eSpark-Consulting-Group/eduardosuarez-roomonitor/Hardware-Designing/_Deliverable/Renderings/3D TopView.jpg

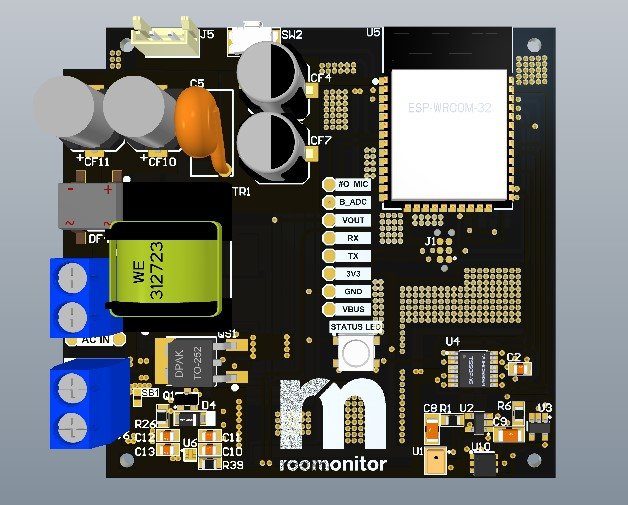
Hardware-Designing/_Deliverable/Renderings/3D TopView.jpg
