eSpark-Consulting-Group/eduardosuarez-roomonitor/Hardware-Designing/_Deliverable/Renderings/3D BottomView.jpg

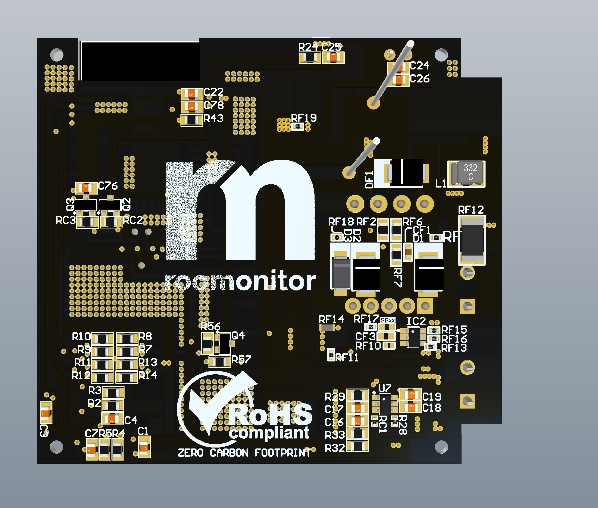
Hardware-Designing/_Deliverable/Renderings/3D BottomView.jpg
