eSpark-Consulting-Group/eduardosuarez-roomonitor/README.md

# RoomMonitor-Eduardo
Design and collaborate on the Hardware Design of IndoorMonitor and OutdoorMonitor for Eduardo Suarez.
