eSpark-Consulting-Group/eduardosuarez-roomonitor/Hardware-Designing/_Deliverable/Renderings/2D BottomView.jpg

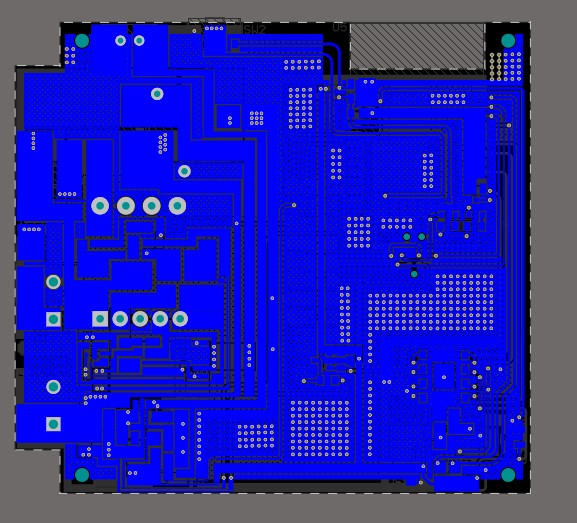
Hardware-Designing/_Deliverable/Renderings/2D BottomView.jpg
