eSpark-Consulting-Group/eduardosuarez-roomonitor/Hardware-Designing/_Deliverable/Renderings/2D C-View.jpg

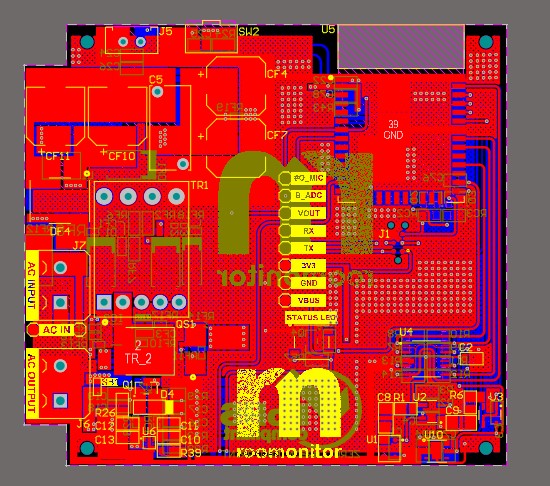
Hardware-Designing/_Deliverable/Renderings/2D C-View.jpg
