eSpark-Consulting-Group/eduardosuarez-roomonitor/Hardware-Designing/_Deliverable/Renderings/2D TopView.jpg

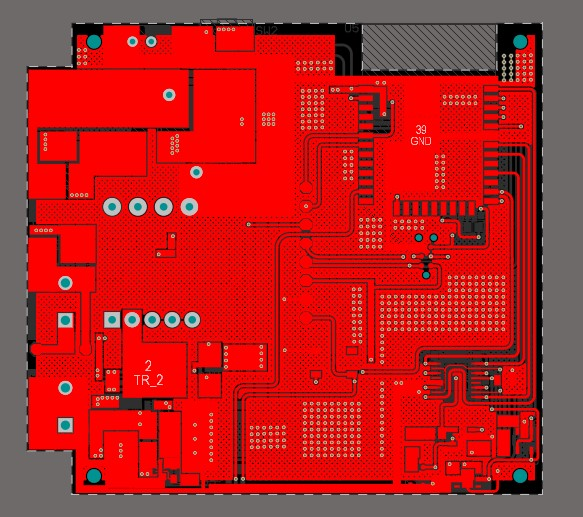
Hardware-Designing/_Deliverable/Renderings/2D TopView.jpg
