eSpark-Consulting-Group/eduardosuarez-roomonitor/Hardware-Designing/_Deliverable/Renderings/3D IsometricView.jpg

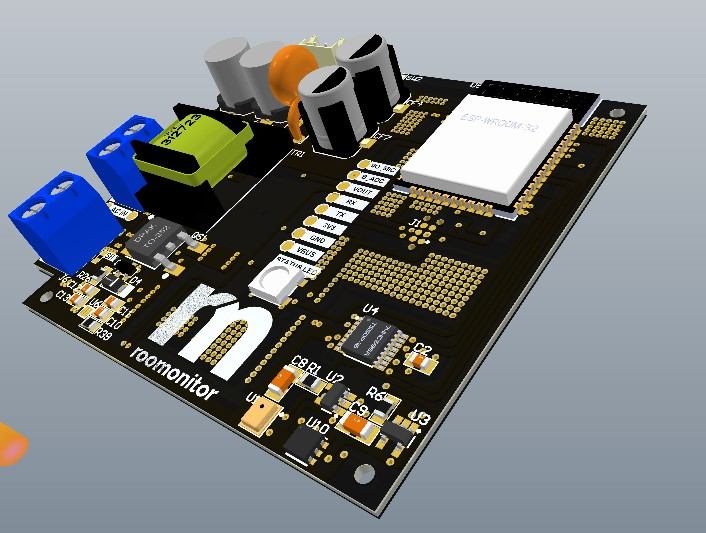
Hardware-Designing/_Deliverable/Renderings/3D IsometricView.jpg
