eSpark-Consulting-Group/eduardosuarez-roomonitor/Hardware-Designing/_Deliverable/Renderings/3D IsometricView_2.jpg

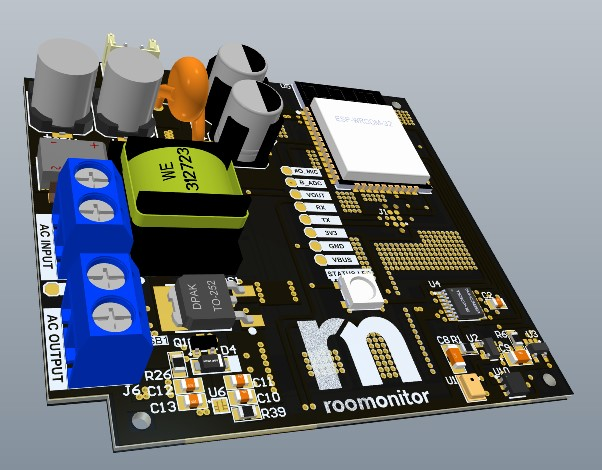
Hardware-Designing/_Deliverable/Renderings/3D IsometricView_2.jpg
