eSpark-Consulting-Group/eduardosuarez-roomonitor/Hardware-Designing/_Deliverable/BOM/EDU BOM.xlsx

Sheet: Sheet1
Bill of Material (BOM) for Eduardo_SMPS
S. No. | Comment Type | Description | Designator | Footprint (Package) | Manufacturer Part Number | Manufacturer | Value | Quantity | Total Quantity | Link | Unit Price(500) | Total Price (500) | Unit Price(1000) | Total Price (1000) | Unit Price(4000) | Total Price(4000) | Remarks
1 | Capacitor | CAP CER 0.1UF 50V Y5V 0805 | C1, C2, C3, C4, C7, C10, C12, C17, C19, C22, C24, C25, C76 | Cap0805 | CL21F104ZBCNNNC | Samsung | 0.1uF | 13 | 650 | Digikey (https://www.digikey.com/en/products/detail/samsung-electro-mechanics/CL21F104ZBCNNNC/3886665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) | $0.0122 | $7.93 | $0.00959 | $6.23 | $0.00802 | $5.21 | no alternate found
2 |  | CAP CER 1000PF 760VAC Y5U RADIAL | C5 | RAD-0.4 | 440LD10-R | Vishay | 1000pF | 1 | 50 | Mouser (https://eu.mouser.com/ProductDetail/Vishay-Cera-Mite/440LD10-R) |  | $0.00 | $0.37000 | $18.50 | $0.37000 | $18.50 | price start from 1000
3 |  | CAP CER 1UF 16V X7R 1206 | C8, C9 | Cap1206 | 1206YC105K4T2A | Kyocera AVX | 1uF | 2 | 100 | Digikey (https://www.digikey.com/en/products/detail/avx-corporation/1206YC105K4T2A/3081814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) |  | $0.00 |  | $0.00 |  | $0.00 | Alternate part on next sheet
4 |  | CAP CER 1UF 16V X7R 0805 | C11, C13, C16, C18, C78 | Cap0805 | CL21B105KOFNNNG | Samsung | 1uF | 5 | 250 | Digikey (https://www.digikey.com/en/products/detail/samsung-electro-mechanics/CL21B105KOFNNNG/3894469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) | $0.0175 | $4.37 | $0.01373 | $3.43 | $0.01249 | $3.12 | not needed to change price for 3000
5 |  | CAP CER 4.7UF 16V 10% X5R 0805 | C26 | Cap0805 | C0805C475K4PACTU | KEMET | 4.7UF | 1 | 50 | Digikey (https://www.digikey.com/en/products/detail/kemet/C0805C475K4PACTU/2057920) | $0.0632 | $3.16 | $0.05591 | $2.80 | $0.04862 | $2.43 | not need to change,price for 5000
6 |  | CAP CER 1000PF 200V X7R 0603 | CF1 | Cap0603 | 0603B102K201CT | Walsin Technologies | 1nF | 1 | 50 | Digikey (https://www.digikey.com/en/products/detail/walsin-technology-corporation/0603B102K201CT/9354876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) | $0.0218 | $1.09 | $0.01712 | $0.86 | $0.01432 | $0.72 | not need to change,price for 4000
7 |  | CAP CER 0.33UF 50V X7R 0603 | CF3 | Cap0603 | CGA3E3X7R1H334M080AB | TDK | 0.33uF | 1 | 50 | Digikey (https://www.digikey.com/en/products/detail/tdk-corporation/CGA3E3X7R1H334M080AB/4931466) |  | $0.00 |  | $0.00 |  | $0.00 | Alternate part on next sheet
8 |  | CAP ALUM 560UF 20% 10V SMD | CF4, CF7 | Custom | EEE-TC1A561UV | Panasonic | 560uF | 2 | 100 | Digikey (https://www.digikey.com/en/products/detail/panasonic-electronic-components/EEE-TC1A561UV/10290506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) | $0.5483 | $54.83 | $0.48375 | $48.38 | $0.43538 | $43.54 | not needed to change,price for 5000
9 |  | CAP ALUM 4.7UF 20% 400V SMD | CF10, CF11 | Custom | ULR2G4R7MNL1GS | Nichicon | 4.7uF | 2 | 100 | Digikey (https://www.digikey.com/en/products/detail/nichicon/ULR2G4R7MNL1GS/3664129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) | $0.3245 | $32.45 | $0.27323 | $27.32 | $0.23908 | $23.91 | not needed to change,price for 5000
10 | Diode | TVS DIODE 70.1V 113V DO214AA | D1 | SMB | SMBJP6KE82A-TP | MCC | -------- | 1 | 50 | Digikey (https://www.digikey.com/en/products/detail/micro-commercial-co/SMBJP6KE82A-TP/2345614) | $0.1235 | $6.17 | $0.10075 | $5.04 | $0.09750 | $4.88 | price for 3000,949 in stock
11 |  | DIODE GEN PURP 600V 1A SMB | D2 | SMB | MURS160-13 | Diodes | -------- | 1 | 50 | Digikey (https://www.digikey.com/en/products/detail/MURS160-13-F/MURS160-FDICT-ND/815906?curr=usd) |  | $0.00 |  | $0.00 |  | $0.00 | not in stock
12 |  | Diode Switching 100V 1A 2Pin SMA | D3 | SMA | RS1B-13-F | Diodes | -------- | 1 | 50 | Digikey (https://www.digikey.com/en/products/detail/diodes-incorporated/RS1B-13-F/717796) | $0.1050 | $5.25 | $0.07676 | $3.84 | $0.07070 | $3.54 | price for 5000
13 |  | DIODE SCHOTTKY 30V 1A SOD123W | D4 | SOD123W | PMEG3010ER,115 | NXP Semiconductors | -------- | 1 | 50 | Digikey (https://www.digikey.com/en/products/detail/nexperia-usa-inc/PMEG3010ER115/2119868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) | $0.1009 | $5.04 | $0.07372 | $3.69 | $0.07178 | $3.59 | price for 3000
14 |  | DIODE SCHOTTKY 40V 3A SMB | DF1 | SMB | B340LB-13-F | Diodes | -------- | 1 | 50 | Digikey (https://www.digikey.com/en/products/detail/diodes-incorporated/B340LB-13-F/755461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) | $0.1727 | $8.64 | $0.13635 | $6.82 | $0.13181 | $6.59 | price for 3000
15 |  | RECT BRIDGE GPP 1A 400V DFS | DF4 | Custom | DF04S-T | Diodes | -------- | 1 | 50 | Digikey (https://www.digikey.com/en/products/detail/diodes-incorporated/DF04S-T/1934941) | $0.1631 | $8.16 | $0.16312 | $8.16 | $0.12878 | $6.44 | price for 3000
16 | LED | ADDRESS LED DISC SERIAL RGB 1=10 | LED2 | 1655 | 1655 | Adafruit Industries | -------- | 1 | 50 | Digikey (https://www.digikey.com/en/products/detail/adafruit-industries-llc/1655/5154679) | $4.5000 | $225.00 | $4.50000 | $225.00 | $4.50000 | $225.00 | same unit for all
17 | Inductor | Ind Power Wirewound 470uH 10% 140mA 1812 | L1 | custom | 84474C | Murata | 470uH | 1 | 50 | Digikey (https://www.digikey.com/en/products/detail/murata-power-solutions-inc/84474C/5798743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) | $0.2295 | $11.47 | $0.22610 | $11.30 | $0.22610 | $11.30 | price for 2000
18 | Mosfet | MOSFET P-CHAN 24V SOT23 | Q1 | SOT-23 | DMP2045U-7 | Diodes | -------- | 1 | 50 | Digikey (https://www.digikey.com/en/products/detail/diodes-incorporated/DMP2045U-7/8275356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) | $0.1252 | $6.26 | $0.09292 | $4.65 | $0.08161 | $4.08 | price for 3000
19 |  | TRANS NPN 40V 0.6A SMD SOT23-3 | Q2, Q3 | SOT-23 | MMBT2222A-7-F | Diodes | -------- | 2 | 100 | Digikey (https://www.digikey.com/en/products/detail/diodes-incorporated/MMBT2222A-7-F/814503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) | $0.0393 | $3.93 | $0.02727 | $2.73 | $0.02382 | $2.38 | price for 3000
20 |  | MOSFET N-CH 50V 200MA SOT-23 | Q4 | SOT-23 | BSS138LT1G | ON Semiconductor | -------- | 1 | 50 | Digikey (https://www.digikey.com/en/products/detail/on-semiconductor/BSS138LT1G/918376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) | $0.0701 | $3.50 | $0.04871 | $2.44 | $0.04527 | $2.26 | price for 3000
21 |  | MOSFET N-CH 600V 2A DPAK | QS1 | DPAK | STD2HNK60Z | STMicroelectronics | -------- | 1 | 50 | Digikey (https://www.digikey.com/en/products/detail/stmicroelectronics/STD2HNK60Z/1653989) | $0.5304 | $26.52 | $0.43210 | $21.61 | $0.38740 | $19.37 | price for 5000
22 | Resistor | RES SMD 1K OHM 5% 1/2W 0805 | R1, R6 | RES0805 | ERJ-P06J102V | Panasonic | 1K | 2 | 100 | Digikey (https://www.digikey.com/en/products/detail/panasonic-electronic-components/ERJ-P06J102V/525197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) |  | $0.00 | $0.01584 | $1.58 | $0.01224 | $1.22 | not needed to change
23 |  | RES SMD 10K OHM 5% 1/2W 0805 | R2, R3, R4, R5, R8, R10, R12, R14, R24, R29, R39, R43, R56, R57, RC2, RC3 | RES0805 | ERJ-P06J103V | Panasonic | 10K | 16 | 800 | Digikey (https://www.digikey.com/en/products/detail/panasonic-electronic-components/ERJ-P06J103V/525198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) |  | $0.00 | $0.01584 | $12.67 | $0.01224 | $9.79 | not needed to change, price for 5000
24 |  | RES SMD 47K OHM 1% 1/3W 0805 | R7 | RES0805 | CRCW080547K0FKEAHP | Vishay | 47K | 1 | 50 | Digikey (https://www.digikey.com/en/products/detail/vishay-dale/CRCW080547K0FKEAHP/2222360) |  | $0.00 | $0.03150 | $1.57 | $0.03150 | $1.57 | same part with less price also less stock (https://www.digikey.com/en/products/detail/vishay-dale/CRCW080547K0JNEAHP/2222394)
25 |  | RES SMD 100K OHM 5% 1/2W 0805 | R9, R26 | RES0805 | ERJ-P06J104V | Panasonic | 100K | 2 | 100 | Digikey (https://www.digikey.com/en/products/detail/panasonic-electronic-components/ERJ-P06J104V/525199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) |  | $0.00 | $0.01584 | $1.58 | $0.01224 | $1.22 | not needed to change,, price for 5000
26 |  | RES SMD 220K OHM 5% 1/2W 0805 | R11 | RES0805 | ERJ-P06J224V | Panasonic | 220K | 1 | 50 | Digikey (https://www.digikey.com/en/products/detail/panasonic-electronic-components/ERJ-P06J224V/525240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) |  | $0.00 | $0.01584 | $0.79 | $0.01224 | $0.61 | not needed to change,, price for 5000
27 |  | RES SMD 470K OHM 1% 1/3W 0805 | R13 | RES0805 | CRCW0805470KFKEAHP | Vishay Dale | 470K | 1 | 50 | Digikey (https://www.digikey.com/en/products/detail/vishay-dale/CRCW0805470KFKEAHP/2227258) |  | $0.00 |  | $0.00 |  | $0.00 | Alternate part on next sheet
28 |  | RES SMD 665 OHM 1% 1/16W 0402 | R28 | Res0402 | RC0402FR-07665RL | Yageo | 665R | 1 | 50 | Digikey (https://www.digikey.com/en/products/detail/yageo/RC0402FR-07665RL/5281068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) |  | $0.00 | $0.00262 | $0.13 | $0.00188 | $0.09 | not needed to change,price for 5000
29 |  | RES SMD 1M OHM 5% 1/2W 0805 | R32, R33 | RES0805 | ERJ-P06J105V | Panasonic | 1M | 2 | 100 | Digikey (https://www.digikey.com/en/products/detail/panasonic-electronic-components/ERJ-P06J105V/525200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) |  | $0.00 | $0.01584 | $1.58 | $0.01224 | $1.22 | not needed to change,price for 5000
30 |  | RES SMD 10K OHM 1% 1/10W 0402 | RC1, RF11, RF17 | Res0402 | ERJ-2RKF1002X | Panasonic | 10K | 3 | 150 | Digikey (https://www.digikey.com/en/products/detail/panasonic-electronic-components/ERJ-2RKF1002X/192073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) |  | $0.00 | $0.00398 | $0.60 | $0.00285 | $0.43 | not needed to change,price for 5000
31 |  | RES 5.11M OHM 1% 1/4W 0805 | RF2, RF6, RF7 | RES 0805 | RK73H2ATTD5114F | KOA Speer | 5.11M | 3 | 150 | Digikey (https://www.digikey.com/en/products/detail/koa-speer-electronics-inc/RK73H2ATTD5114F/10234574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) |  | $0.00 | $0.00557 | $0.84 | $0.00399 | $0.60 | not needed to change,price for 5000
32 |  | RES 487 OHM 1% 1/10W 0402 | RF8 | Res0402 | RK73H1ETTP4870F | KOA Speer | 487R | 1 | 50 | Digikey (https://www.digikey.com/en/products/detail/koa-speer-electronics-inc/RK73H1ETTP4870F/9844141) |  | $0.00 |  | $0.00 |  | $0.00 | Alternate part on next sheet
33 |  | RES 10 OHM 5% 1/10W 0402 | RF10 | Res0402 | RK73B1ETTP100J | KOA Speer | 10R | 1 | 50 | Digikey (https://www.digikey.com/en/products/detail/koa-speer-electronics-inc/RK73B1ETTP100J/9843968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) |  | $0.00 | $0.00265 | $0.13 | $0.00190 | $0.10 | not needed to change,price for 5000
34 |  | RES SMD 10 OHM 5% 3W 2512 | RF12 | RES 2512 | 352210RJT | TE Connectivity CGS | 10R | 1 | 50 | Digikey (https://www.digikey.com/en/products/detail/te-connectivity-passive-product/352210RJT/5244975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) |  | $0.00 | $0.18411 | $9.21 | $0.18211 | $9.11 | not needed to change,price for 2000
35 |  | RES 4.64K OHM 1% 1/10W 0402 | RF13 | Res-0402 | RK73H1ETTP4641F | KOA Speer | 4.64K | 1 | 50 | Digikey (https://www.digikey.com/en/products/detail/koa-speer-electronics-inc/RK73H1ETTP4641F/9844303) |  | $0.00 | $0.00398 | $0.20 | $0.00285 | $0.14 | not needed to change,price for 5000
36 |  | RES SMD 2.05 OHM 1% 1/10W 0603 | RF14 | Res0603 | CRCW06032R05FKEA | Vishay Dale | 2.05R | 1 | 50 | Digikey (https://www.digikey.com/en/products/detail/vishay-dale/CRCW06032R05FKEA/1961570) |  | $0.00 | $0.00694 | $0.35 | $0.00498 | $0.25 | not needed to change,price for 5000
37 |  | RES SMD 121K OHM 1% 1/10W 0402 | RF15 | Res0402 | ERJ-2RKF1213X | Panasonic | 121K | 1 | 50 | Digikey (https://www.digikey.com/en/products/detail/panasonic-electronic-components/ERJ-2RKF1213X/192111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) |  | $0.00 | $0.00398 | $0.20 | $0.00285 | $0.14 | not needed to change,price for 5000
38 |  | RES 30.1K OHM 1% 1/10W 0402 | RF16 | Res0402 | RK73H1ETTP3012F | KOA Speer | 30.1K | 1 | 50 | Digikey (https://www.digikey.com/en/products/detail/koa-speer-electronics-inc/RK73H1ETTP3012F/9844092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) |  | $0.00 | $0.00398 | $0.20 | $0.00285 | $0.14 | not needed to change,price for 5000
39 |  | RES SMD 22.6 OHM 1% 1/10W 0402 | RF18 | Res0402 | ERJ-2RKF22R6X | Panasonic | 22.6R | 1 | 50 | Digikey (https://www.digikey.com/en/products/detail/panasonic-electronic-components/ERJ-2RKF22R6X/79731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) |  | $0.00 | $0.00398 | $0.20 | $0.00285 | $0.14 | not needed to change,price for 5000
40 |  | RES SMD 3.01K OHM 1% 1/10W 0402 | RF19 | Res-0402 | ERJ-2RKF3011X | Panasonic | 3.01K | 1 | 50 | Digikey (https://www.digikey.com/en/products/detail/panasonic-electronic-components/ERJ-2RKF3011X/192277) |  | $0.00 | $0.00398 | $0.20 | $0.00285 | $0.14 | not needed to change,price for 5000
41 | Switch | SWITCH TACTILE SPST-NO 0.05A 12V | SW2 | Custom | B3U-1000P | Omron Electronics Inc-EMC Div | --------- | 1 | 50 | Digikey (https://www.digikey.com/product-detail/en/c-k/KSS221GLFS/401-1097-1-ND/417665) | $0.6043 | $30.22 | $0.56018 | $28.01 | $0.50925 | $25.46 | price for 3500
42 | Transformer | FLYBACK XFRM WE-FB T-WIN | TR1 | Custom | 750312723 | Wurth Electronics Midcom | --------- | 1 | 50 | Digikey (https://www.digikey.com/en/products/detail/w%C3%BCrth-elektronik/750311558/3992650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) | $3.8330 | $191.65 |  | $0.00 |  | $0.00 | 96 In Stock
43 | IC | SPU-TOP MIC IOT FOCUSED MIC | U1 | Custom | SPU0410HR5H-PB | Knowles | --------- | 1 | 50 | Digikey (https://www.digikey.com/product-detail/en/knowles/SPU0410HR5H-PB/423-1138-1-ND/2420982) | $0.5837 | $29.19 | $0.54985 | $27.49 | $0.47562 | $23.78 | price for 5700
44 |  | IC OPAMP GP 1 CIRCUIT SOT23-5 | U2, U3 | SOT23-5 | OPA344NA/250 | Texas Instruments | --------- | 2 | 100 | Digikey (https://www.digikey.com/product-detail/en/texas-instruments/OPA344NA-250/OPA344NACT-ND/362263) | $0.8908 | $89.08 | $0.70740 | $70.74 | $0.65500 | $65.50 | price for 6250
45 |  | IC SWITCH QUAD SPST 16TSSOP | U4 | 16-TSSOP | ADG712BRUZ-REEL | Analog Devices | --------- | 1 | 50 | Digikey (https://www.digikey.com/product-detail/en/analog-devices-inc/ADG712BRUZ-REEL/ADG712BRUZ-REELCT-ND/3771193) | $1.6960 | $84.80 | $1.53700 | $76.85 | $2500.00000 | $125000.00 | price for 2500
46 |  | WIFI MODULE 128MBITS SPI FLASH | U5 | Custom | ESP32-WROOM-32 (16MB) | Espressif Systems | --------- | 1 | 50 | Digikey (https://www.digikey.com/product-detail/en/espressif-systems/ESP32-WROOM-32D-16MB/1904-1025-1-ND/9381734) | $2250.0000 | $112500.00 |  | $0.00 |  | $0.00 | 887 in stock,comes with unit price
47 |  | IC REG LINEAR 3.3V 1A 8XDFN | U6 | 8XDFN | NCP186AMX330TAG | ON Semiconductor | --------- | 1 | 50 | Digikey (https://www.digikey.com/product-detail/en/on-semiconductor/NCP186AMX330TAG/NCP186AMX330TAGOSCT-ND/5761671) | $0.1771 | $8.86 | $0.13283 | $6.64 | $0.11673 | $5.84 | price for 6000
48 |  | IC BAT CHG LI-ION 1 CELL SOT23-6 | U7 | SOT-23-6 | BQ21040DBVR | Texas Instruments | --------- | 1 | 50 | Digikey (https://www.digikey.com/product-detail/en/texas-instruments/BQ21040DBVR/296-47315-1-ND/7688325) | $0.6480 | $32.40 | $0.50400 | $25.20 | $0.46080 | $23.04 | price for 6000
49 |  | SENS HUMID/TEMP 3.6V I2C 2% 6DFN | U10 | 6DFN | SI7021-A20-GM1R | Silicon Labs | --------- | 1 | 50 | Digikey (https://www.digikey.com/en/products/detail/silicon-labs/SI7021-A20-GM1R/5048935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) |  | $0.00 |  | $0.00 |  | $0.00 | price break limited to 100
50 |  | IC REG CTRLR FLYBK ISO SOT23-6 | IC2 | SOT-23-6 | UCC28700DBVR | Texas Instruments | --------- | 1 | 50 | Digikey (https://www.digikey.com/en/products/detail/texas-instruments/UCC28700DBVR/3588896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) | $0.6300 | $31.50 | $0.49000 | $24.50 | $0.44800 | $22.40 | price for 6000
51 | Connector | CABLE ADAPTER 6 POS | J1 | Custom | TC2030-IDC | Tag-Connect | --------- | 1 | 3 | Digikey (https://www.digikey.com/en/products/detail/tag-connect-llc/TC2030-IDC/4571121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) | $42.4400 | $127.32 | $42.44000 | $127.32 | $42.44000 | $127.32 | same unit price for all
52 |  | CONN HEADER VERT 2POS 2.5MM | J5 | Custom | B2B-EH-A(LF)(SN) | JST | --------- | 1 | 50 | Digikey (https://www.digikey.com/products/en?keywords=B2B-EH-A(LF)(SN)) |  | $0.00 | $0.05861 | $2.93 |  | $0.00 | price break not for 500 and 5000
53 |  | TERMINAL BLOCK 2POS 5.08MM SIDE | J6, J7 | Custom | Terminal Block 2POS | TE Connectivity | --------- | 2 | 100 | Digikey (https://www.digikey.com/product-detail/en/te-connectivity-amp-connectors/1776493-2/A122765-ND/2293915) | $0.3931 | $39.31 | $0.35170 | $35.17 | $0.27515 | $27.52 | price for 5000
54 |  | Test Point ON | P2, P4, P5, P6, P7, P8, P9, P18, P19, P20 | Custom | TEST POINT |  | --------- | 10 | 50 | DO NOT Mount |  | $0.00 |  | $0.00 |  | $0.00
55 |  | Solder Bridge ON | SB1, SBxx | Custom | Solder Bridge |  | --------- | 2 | 10 | DO NOT Mount |  | $0.00 |  | $0.00 |  | $0.00
 |  |  |  |  |  |  |  | Total Component Cost |  |  |  | $113578.09 |  | $859.657 |  | $125734.646
 |  | Notes: |  |  |  |  |  | Custom Charges
 |  | 1- The costing is done for Fifty (50) boards. All components will be calculated with multiplication factor Fifty (50). |  |  |  |  |  | Shipping Charges
 |  | 2- Supplier costing and custom charges are added in the final cost. |  |  |  |  |  | Total

Sheet: Sheet2
CL31B105KOFNNNE
C1608X5R1H334M080AB
CMP0805-FX-4703ELF
ERJ-2RKF4870X
