eSpark-Consulting-Group/eduardosuarez-roomonitor/Hardware-Designing/_Documents/Step files/User Library-WX DC.step

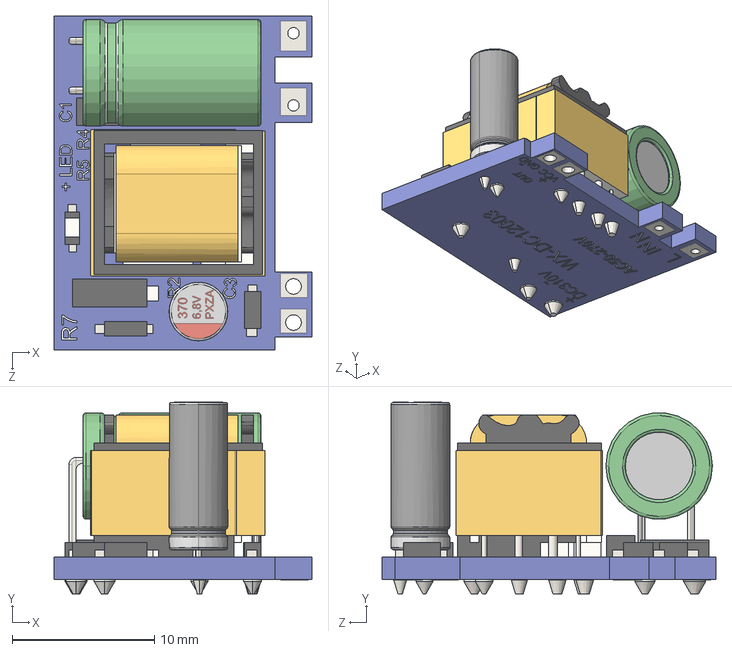
[picture p9: CAD file, 2021-03-09]
Hardware-Designing/_Documents/Step files/User Library-WX DC.step
18.1 x 13.5 x 23.5 mm
