eSpark-Consulting-Group/eduardosuarez-roomonitor/Library-Files/Step files/User Library-MSOP8.step

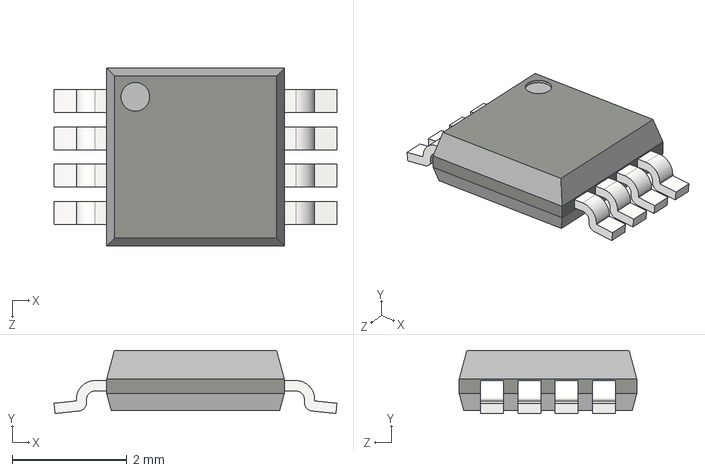
[picture p10: CAD file, 2021-03-06]
Library-Files/Step files/User Library-MSOP8.step
4.94 x 1.10 x 3.10 mm
