eSpark-Consulting-Group/eduardosuarez-roomonitor/Hardware-Designing/_Design Files v4.5/mid-olti-312723.stp

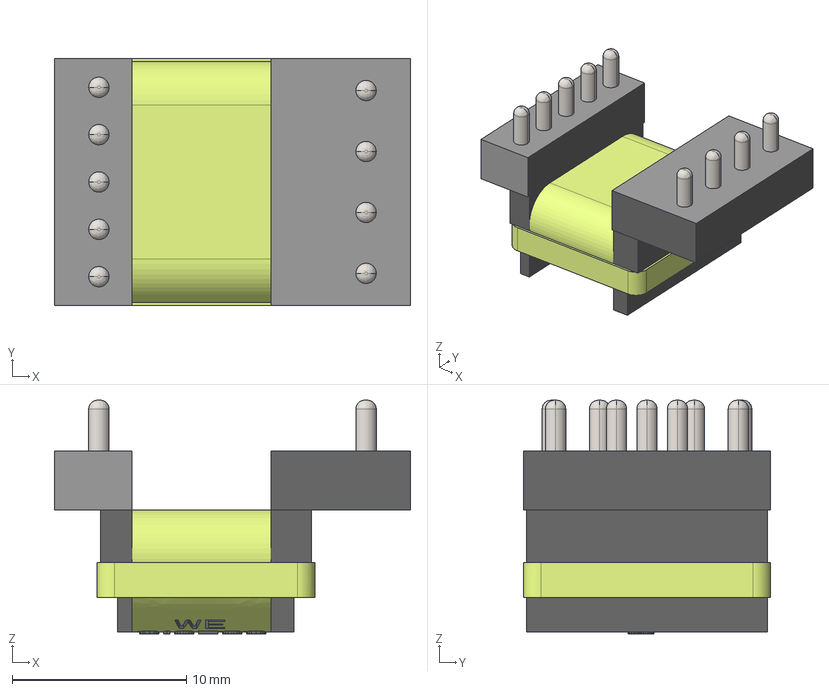
[picture p11: CAD file, 2021-03-06]
Hardware-Designing/_Design Files v4.5/mid-olti-312723.stp
20.4 x 14.2 x 13.4 mm
