eSpark-Consulting-Group/eduardosuarez-roomonitor/Hardware-Designing/_Documents/Step files/TSW-202-07-T-S.stp

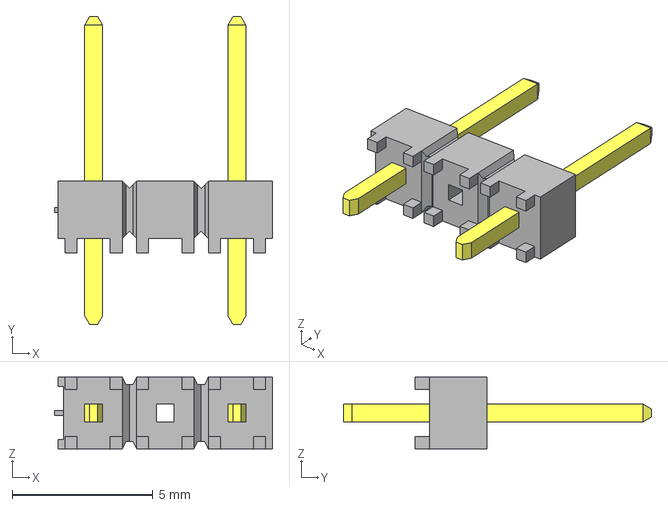
[picture p12: CAD file, 2021-03-09]
Hardware-Designing/_Documents/Step files/TSW-202-07-T-S.stp
7.75 x 10.9 x 2.54 mm
_TSW-202-07-T-S_body
_T-1S6-07-TSW-2-07-2-S
