eSpark-Consulting-Group/eduardosuarez-roomonitor/Library-Files/Step files/User Library-SOT23-6-2.step

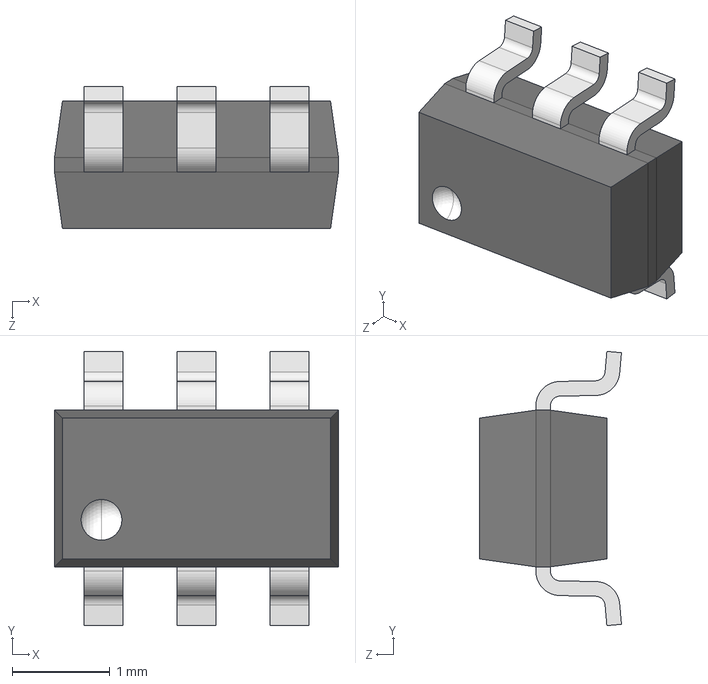
[picture p13: CAD file, 2021-03-06]
Library-Files/Step files/User Library-SOT23-6-2.step
2.90 x 2.80 x 1.45 mm
