eSpark-Consulting-Group/eduardosuarez-roomonitor/Library-Files/Step files/DFN6_3X3.step

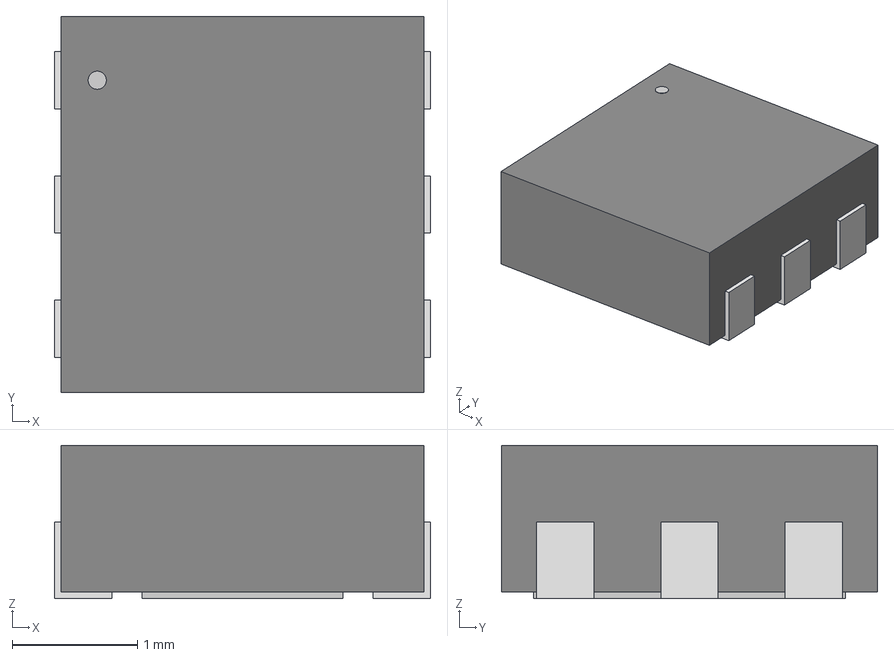
[picture p14: CAD file, 2021-03-06]
Library-Files/Step files/DFN6_3X3.step
3.00 x 3.00 x 1.22 mm
