eSpark-Consulting-Group/eduardosuarez-roomonitor/Library-Files/Step files/esp32s_dev_board_0_9inch_new.stp

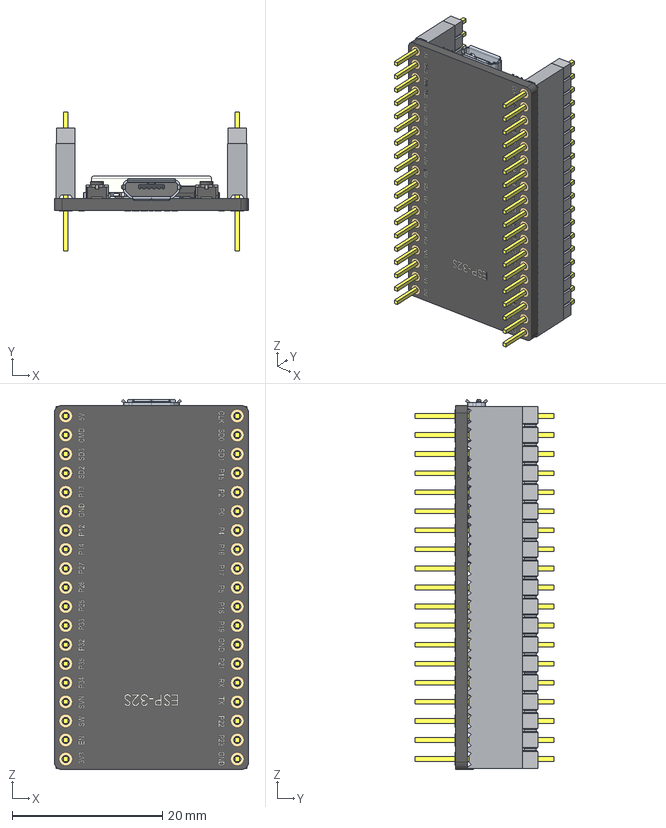
[picture p15: CAD file, 2021-03-06]
Library-Files/Step files/esp32s_dev_board_0_9inch_new.stp
25.9 x 18.5 x 49.3 mm
0402_SMD_CAPACITOR x 2
IMPORTED6
IMPORTED25
IMPORTED29
IMPORTED8
IMPORTED26
IMPORTED7
IMPORTED16
IMPORTED20
CUT-EXTRUDE1
IMPORTED10
IMPORTED15
IMPORTED23
IMPORTED21
IMPORTED11
IMPORTED12
IMPORTED14
IMPORTED4
IMPORTED17
IMPORTED5
IMPORTED24
IMPORTED13
IMPORTED28
IMPORTED18
IMPORTED19
IMPORTED22
IMPORTED9
IMPORTED2
IMPORTED27
IMPORTED3
0603_SMD_RESISTOR
MIRROR3 x 2
ESP-WROOM-32
SOD323F-1
SOT-23 x 2
ESP32S_HW-573_PCB
0603_SMD_CAPACITOR
CIRCUITWORKS-SOT-223
MICRO_USB_47346-0001
0805_SMD_CAPACITOR
LEAD1 x 2
COVER x 2
LEAD2 x 2
LED x 2
POL_CAP_SMD_3528_H2MM
FEMALE_HEADER x 2
_HMTSW-119-09-T-S-085_BODY x 2
_HMTSW-119-09-S-085 x 2
