eSpark-Consulting-Group/eduardosuarez-roomonitor/Library-Files/Step files/User Library-Bridge rectifier DFS package-1.step

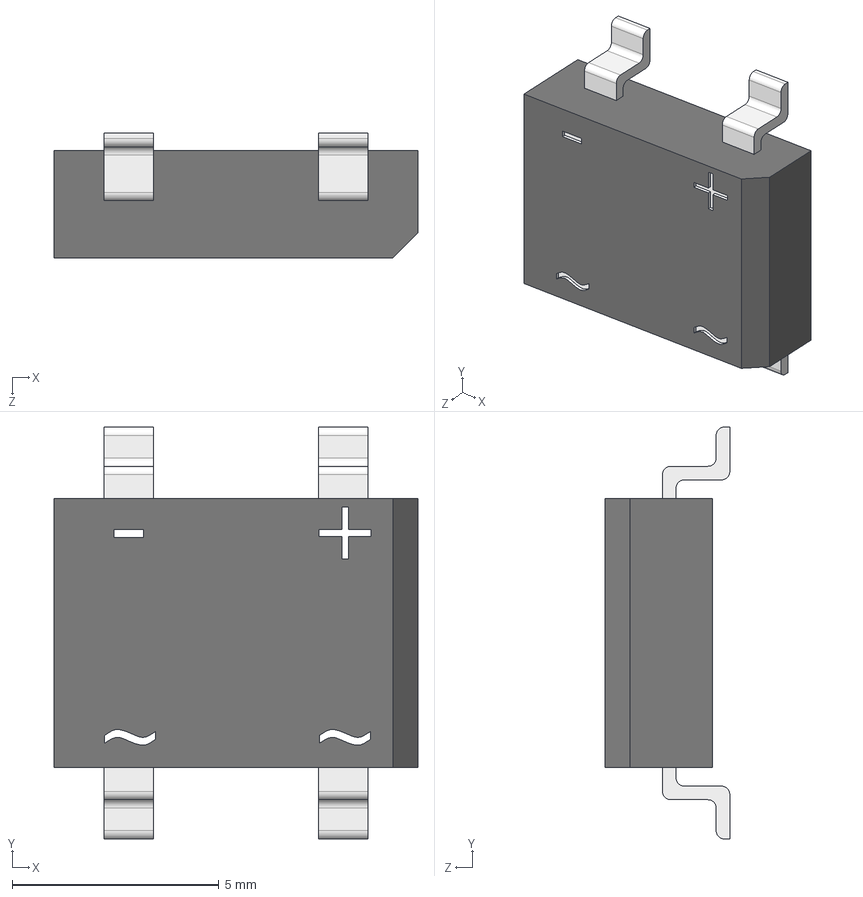
[picture p16: CAD file, 2021-03-06]
Library-Files/Step files/User Library-Bridge rectifier DFS package-1.step
8.80 x 9.97 x 3.02 mm
