eSpark-Consulting-Group/eduardosuarez-roomonitor/Library-Files/Step files/User Library-TSSOP-16-for-ON-SEMI-MC74HC595ADTR2G-Text.step

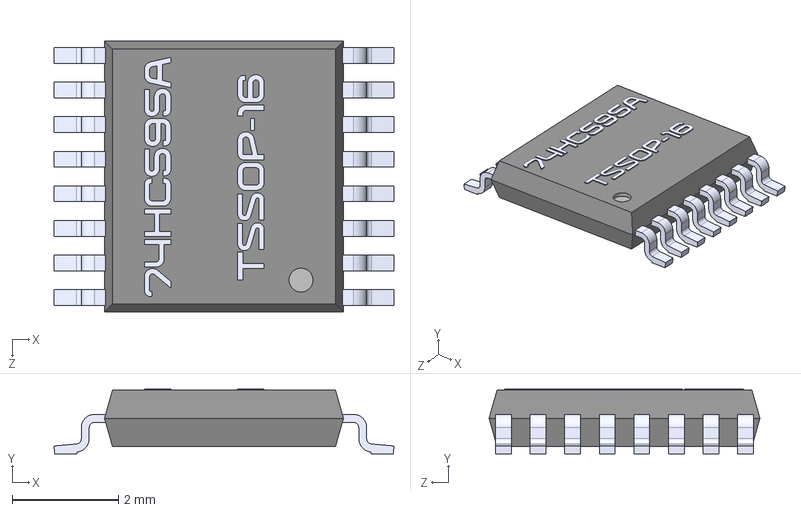
[picture p17: CAD file, 2021-03-06]
Library-Files/Step files/User Library-TSSOP-16-for-ON-SEMI-MC74HC595ADTR2G-Text.step
6.40 x 1.22 x 5.10 mm
