eSpark-Consulting-Group/eduardosuarez-roomonitor/Library-Files/Step files/User Library-SOT95P280X135-3M[SOT23_TO-236AA].step

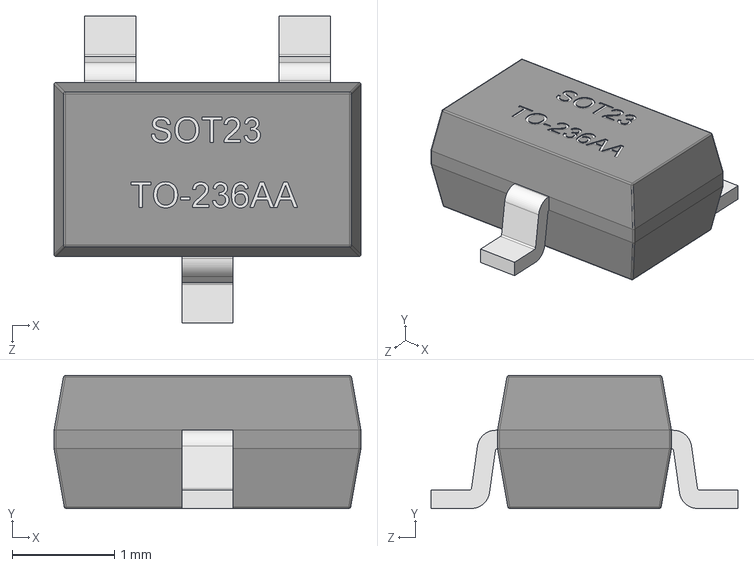
[picture p18: CAD file, 2021-03-06]
Library-Files/Step files/User Library-SOT95P280X135-3M[SOT23_TO-236AA].step
3.00 x 1.30 x 3.00 mm
