eSpark-Consulting-Group/eduardosuarez-roomonitor/Library-Files/Step files/â¦10 SIZE CODE G.stp

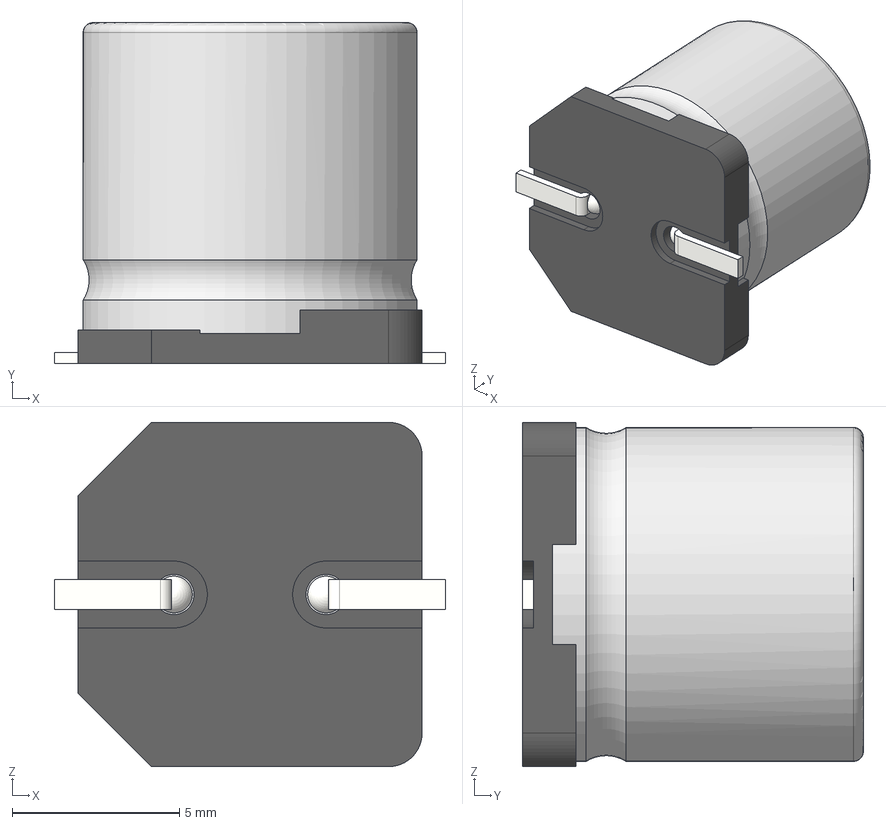
[picture p19: CAD file, 2021-03-06]
Library-Files/Step files/â¦10 SIZE CODE G.stp
11.7 x 10.2 x 10.3 mm
標準品ケースΦ10x9.3L SIDE CODE G
標準品座版Φ10 SIZE CODE G
標準品リード線Φ10 SIZE CODE G改 x 2
