eSpark-Consulting-Group/eduardosuarez-roomonitor/Library-Files/Step files/User Library-sot353.step

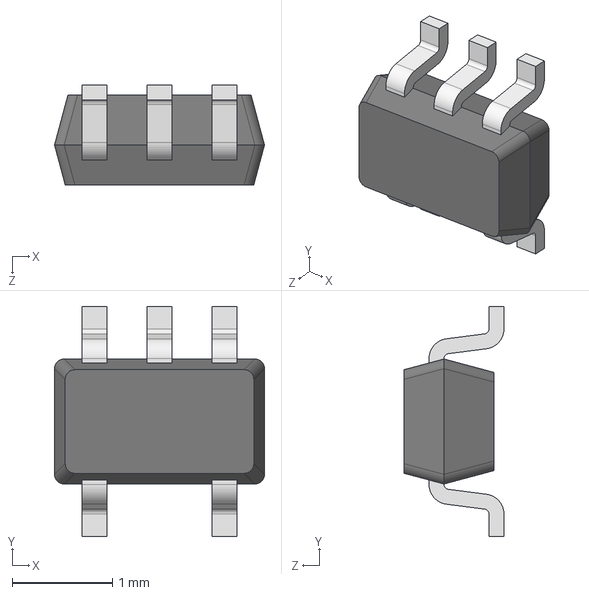
[picture p20: CAD file, 2021-03-06]
Library-Files/Step files/User Library-sot353.step
2.10 x 2.30 x 1.00 mm
