eSpark-Consulting-Group/eduardosuarez-roomonitor/Library-Files/Step files/User Library-2410 fuse.step

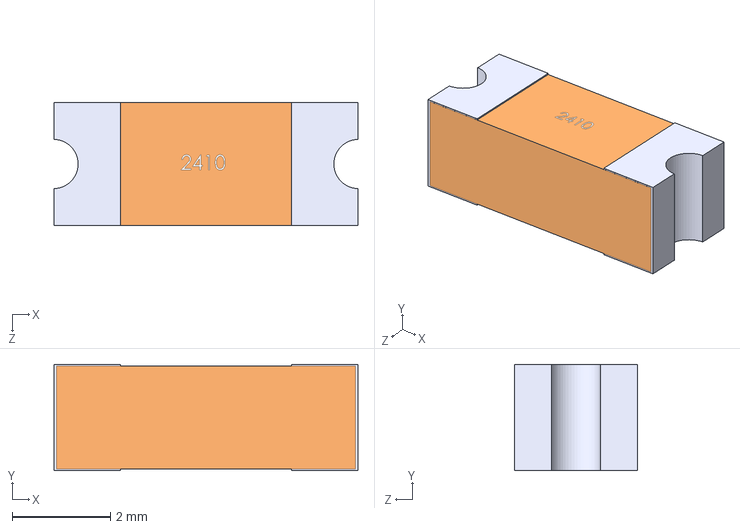
[picture p21: CAD file, 2021-03-06]
Library-Files/Step files/User Library-2410 fuse.step
6.18 x 2.16 x 2.50 mm
