eSpark-Consulting-Group/eduardosuarez-roomonitor/Library-Files/Step files/User Library-led0603_RED-1.STEP

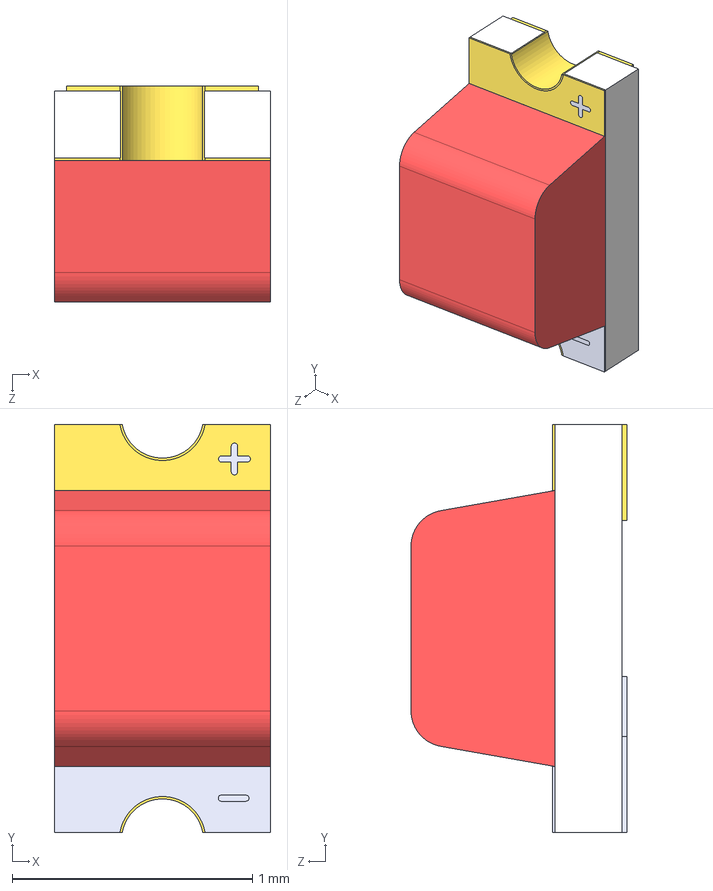
[picture p22: CAD file, 2021-03-06]
Library-Files/Step files/User Library-led0603_RED-1.STEP
0.9 x 1.70 x 0.9 mm
User_Library-LTST-C190GKT_Pad005
User_Library-LTST-C190GKT_Pad001
User_Library-LTST-C190GKT_Pad006
User_Library-LTST-C190GKT_Pad004
User_Library-LTST-C190GKT_Pad003
User_Library-LTST-C190GKT_Pad007
User_Library-LTST-C190GKT_Lens
User_Library-LTST-C190GKT_Pad
String+
String-
