eSpark-Consulting-Group/eduardosuarez-roomonitor/Library-Files/Step files/HMTSW-119-09-T-S-085.stp

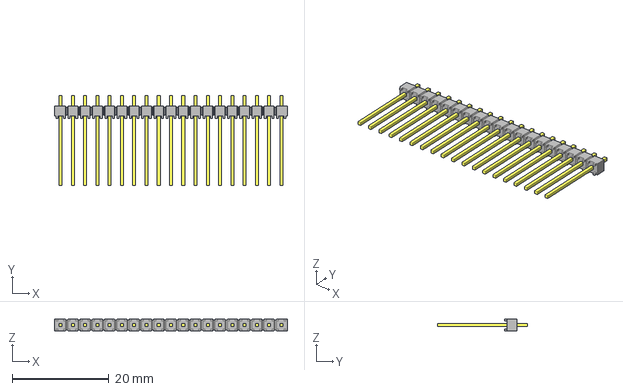
[picture p23: CAD file, 2021-03-06]
Library-Files/Step files/HMTSW-119-09-T-S-085.stp
48.3 x 18.5 x 2.49 mm
_HMTSW-119-09-T-S-085_body
_HMTSW-119-09-S-085
