eSpark-Consulting-Group/eduardosuarez-roomonitor/Library-Files/Step files/CAP_EEEHB_D_PAN.step

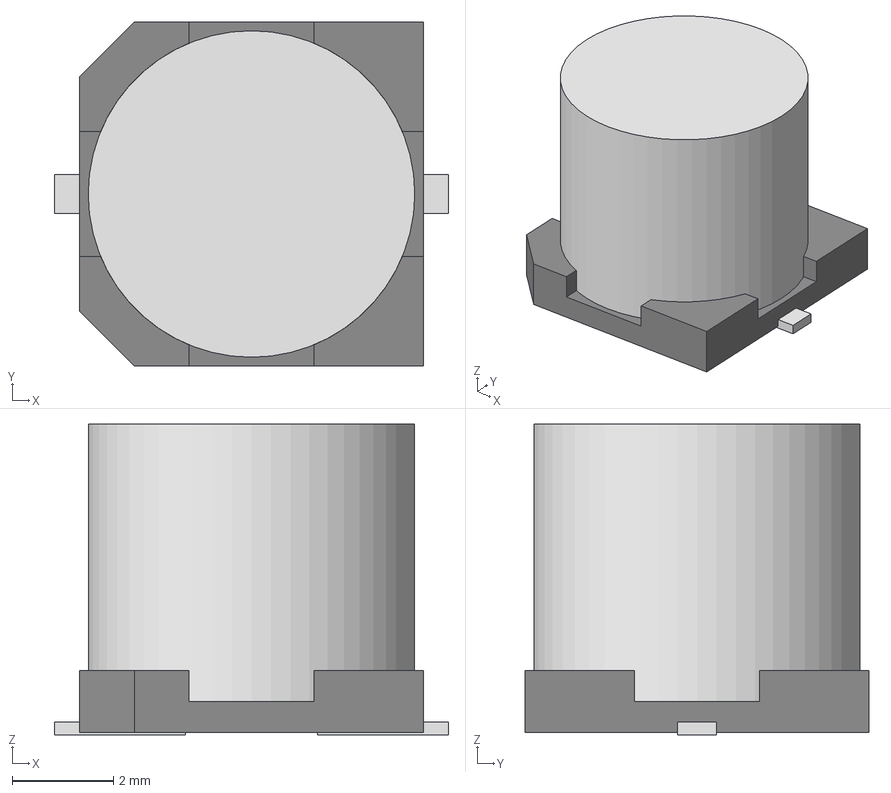
[picture p24: CAD file, 2021-03-06]
Library-Files/Step files/CAP_EEEHB_D_PAN.step
7.80 x 6.81 x 6.15 mm
