eSpark-Consulting-Group/eduardosuarez-roomonitor/(list of files, cad)

Other CAD files:
Hardware-Designing/Step files/1744037-2.stp
Hardware-Designing/Step files/61300211121_Download_STP_61300211121_rev1.stp
Hardware-Designing/_Deliverable/Supporting Files/Audio_Meter_V4.5.DXF
Hardware-Designing/_Design Files v4.5/Audio_Meter_V4.5.DXF
Hardware-Designing/_Documents/Step files/1744037-2.stp
Hardware-Designing/_Documents/Step files/61300211121_Download_STP_61300211121_rev1.stp
