eSpark-Consulting-Group/eduardosuarez-roomonitor/Hardware-Designing/_Design Files v4.5/Audio_Meter_V4.5.pdf

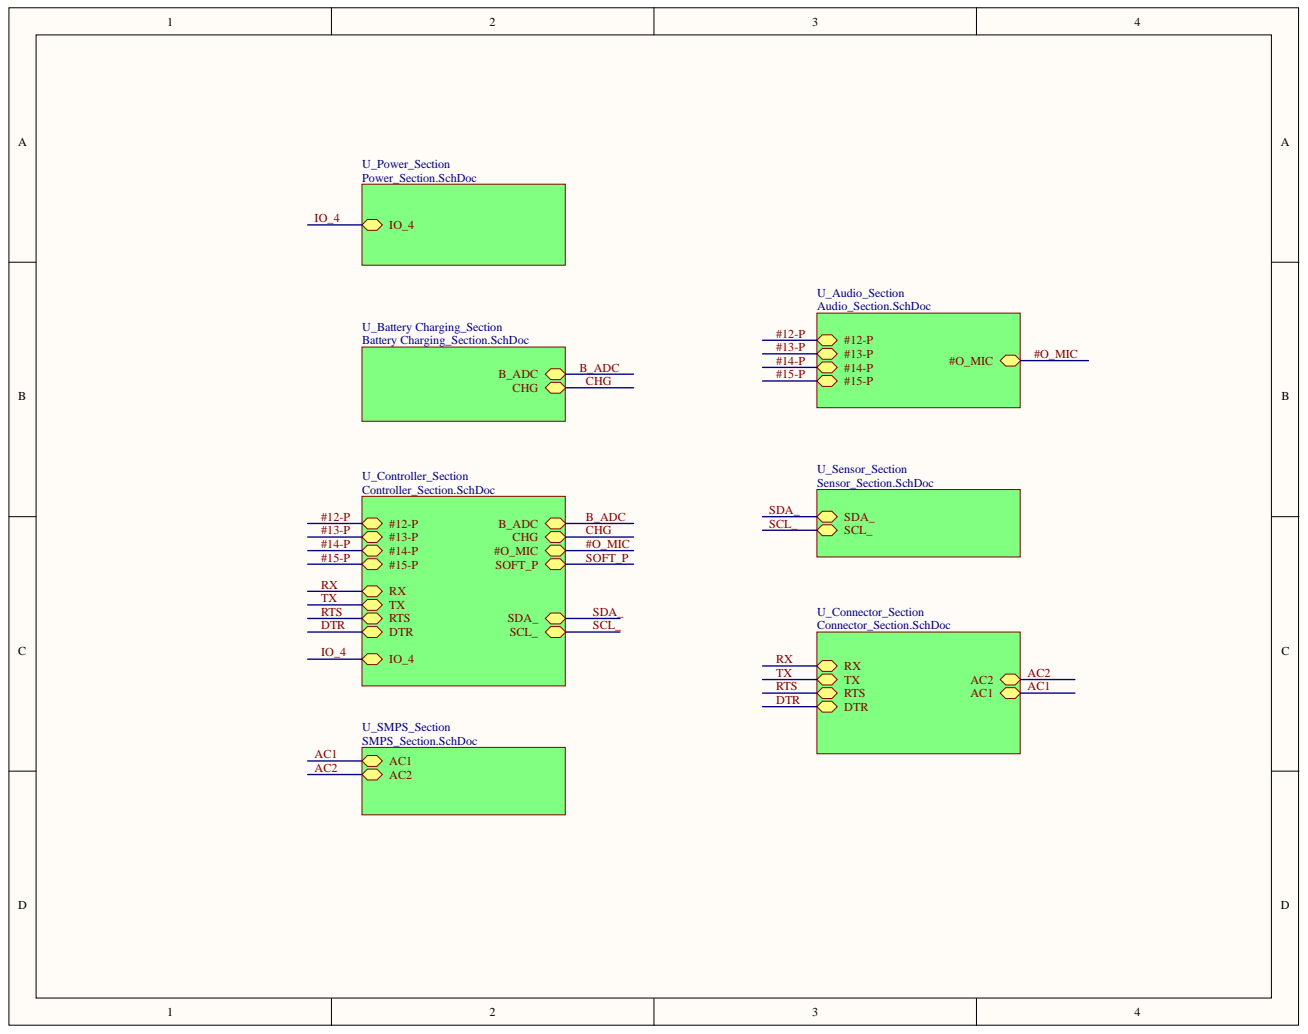
[picture p25: page 1]

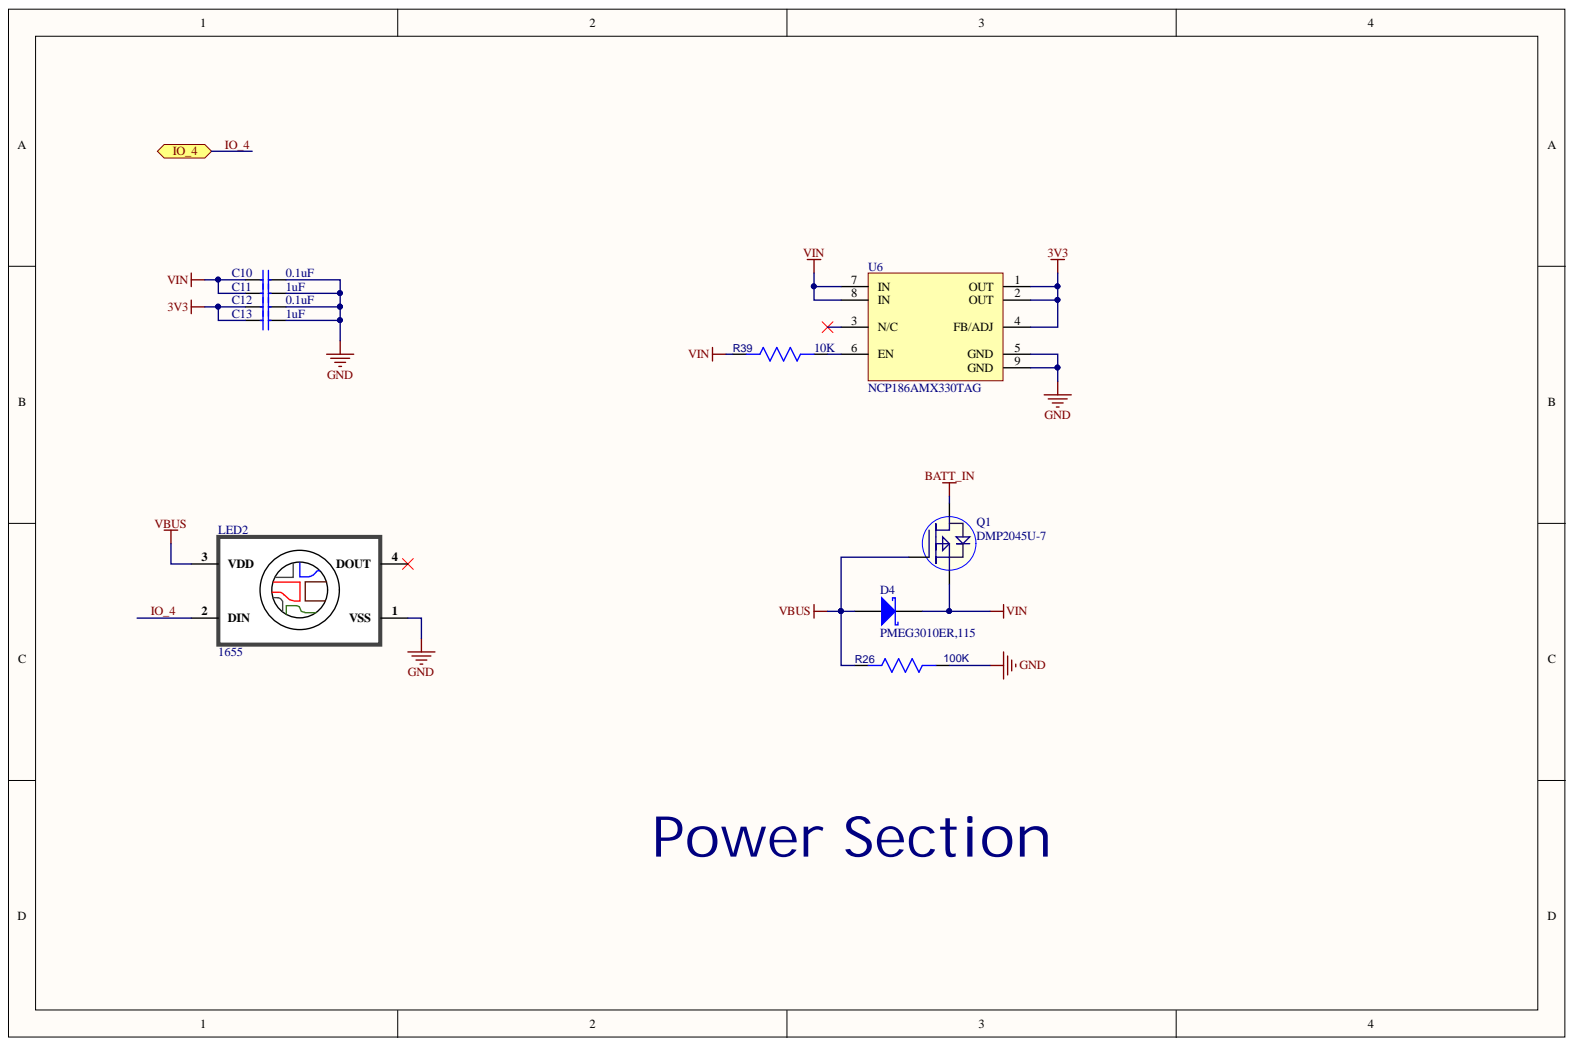
[picture p26: page 2]

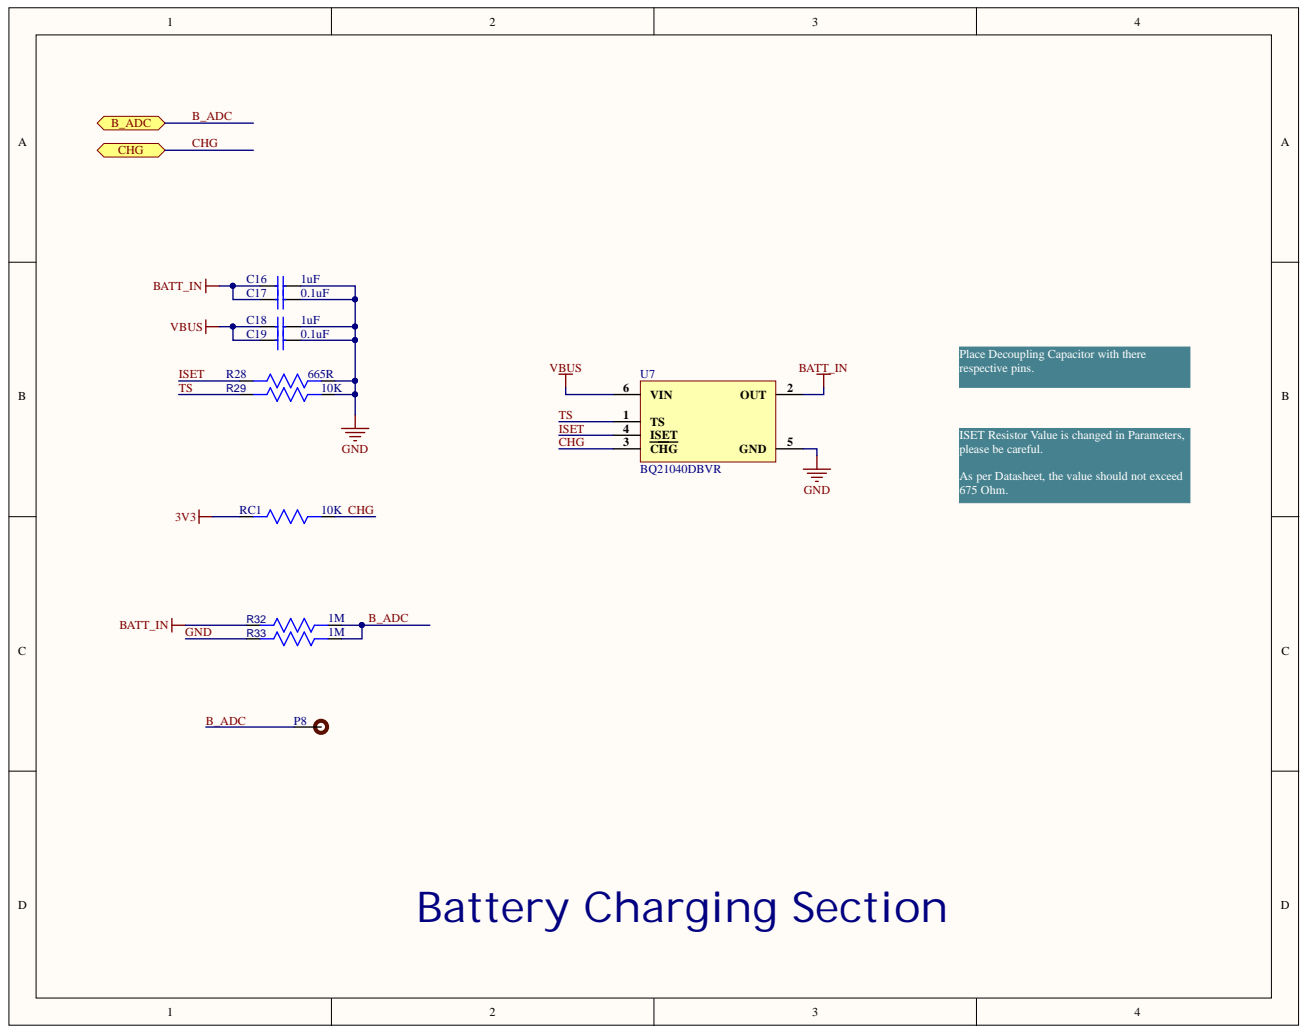
[picture p27: page 3]

Place Decoupling Capacitor with there
respective pins.

ISET Resistor Value is changed in Parameters,
please be careful.

As per Datasheet, the value should not exceed
675 Ohm.

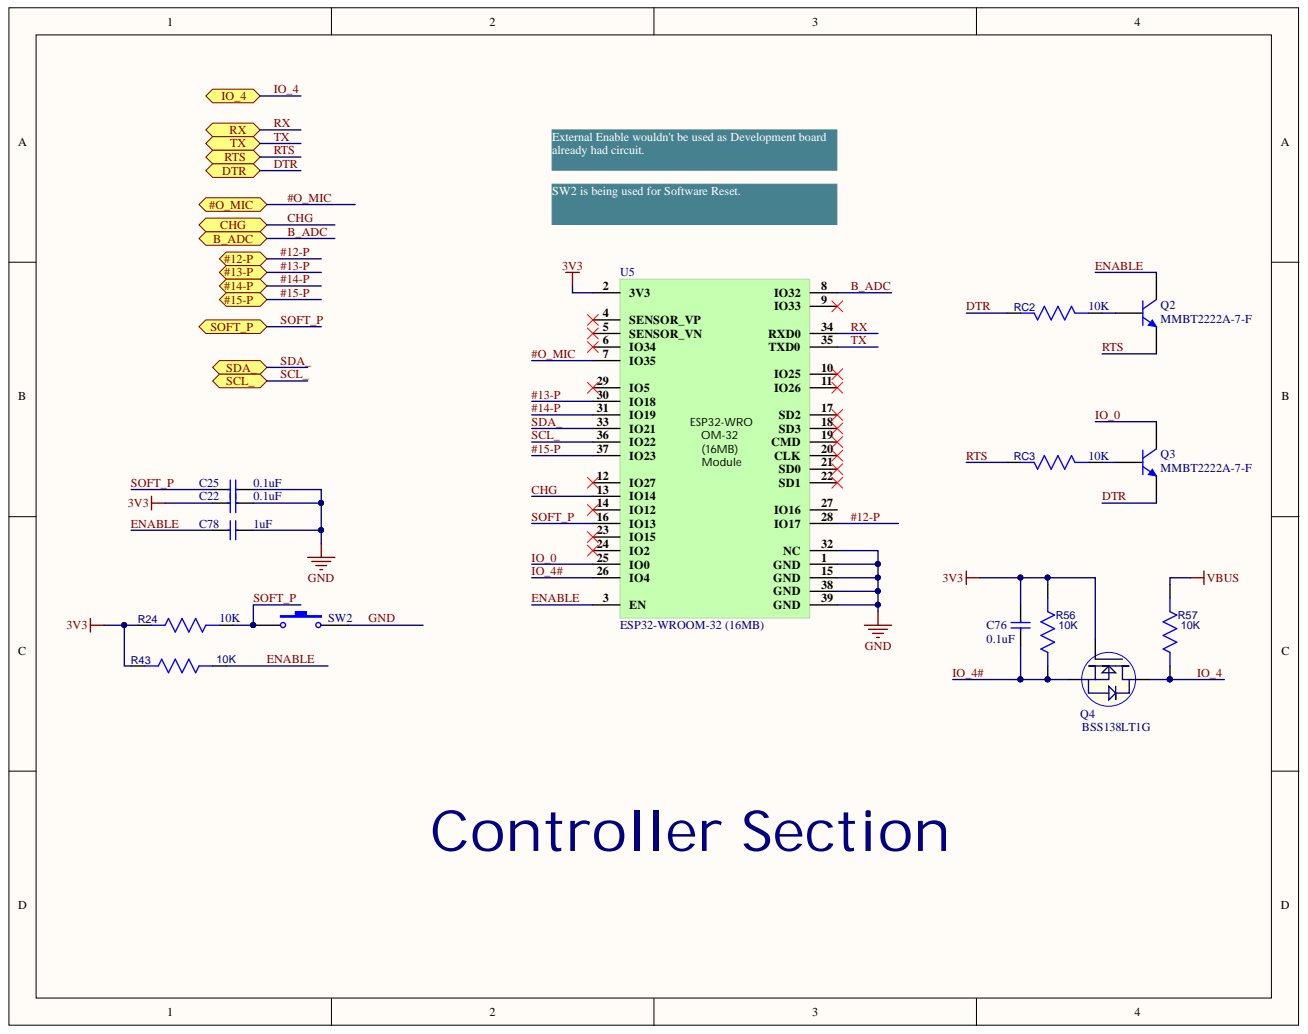
[picture p28: page 4]

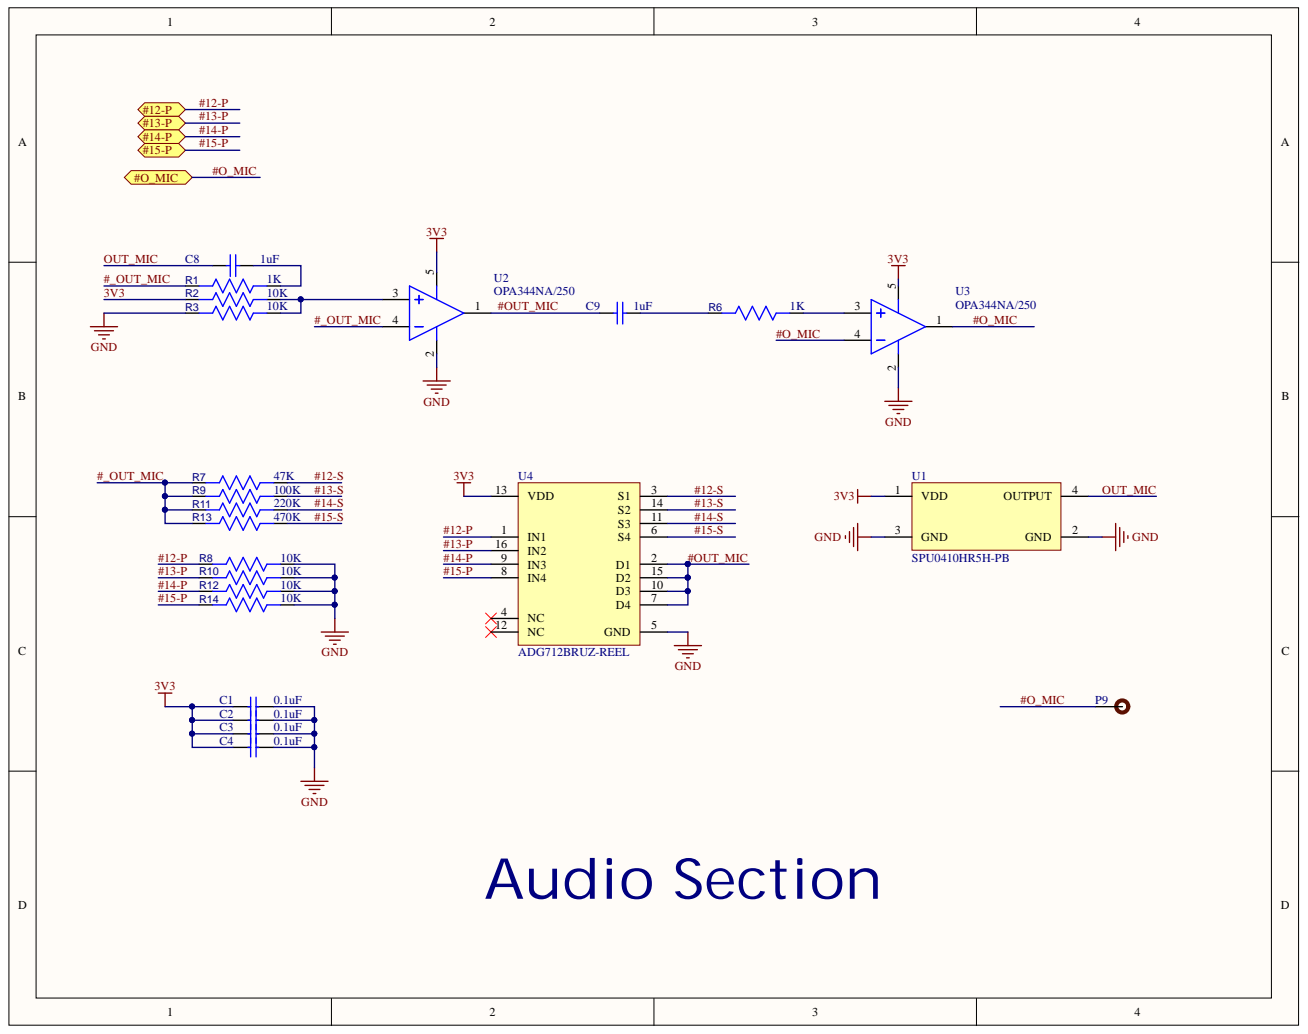
[picture p29: page 5]

C2 | | 0.1uF
C3 | | 0.1uF
C4 | 0.1uF

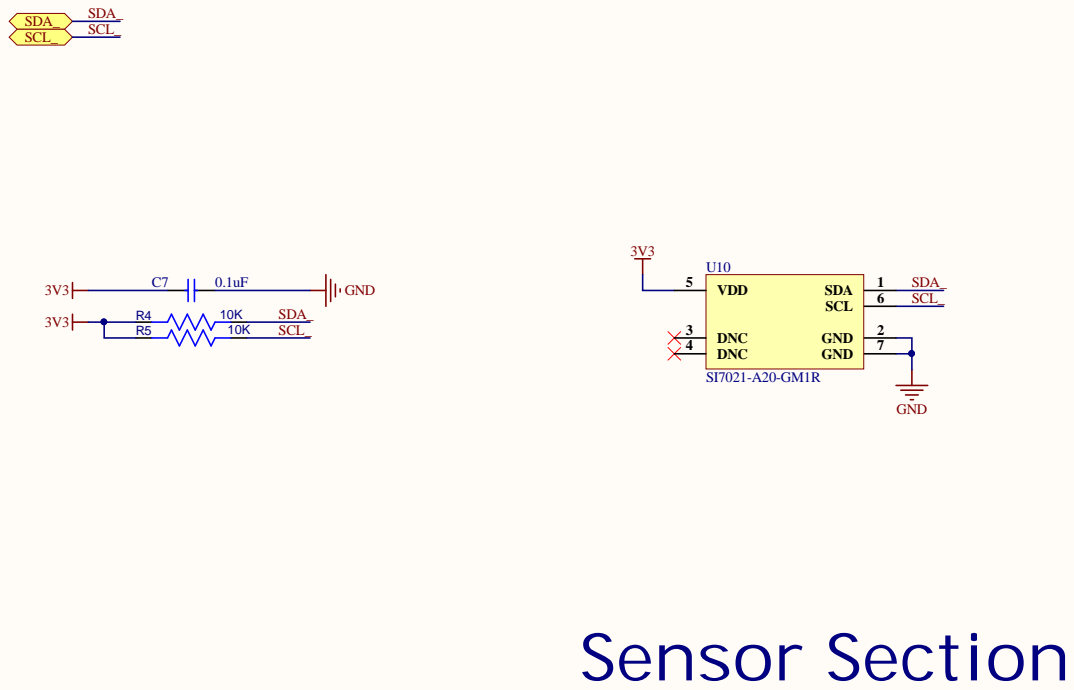
[picture p30: page 6]

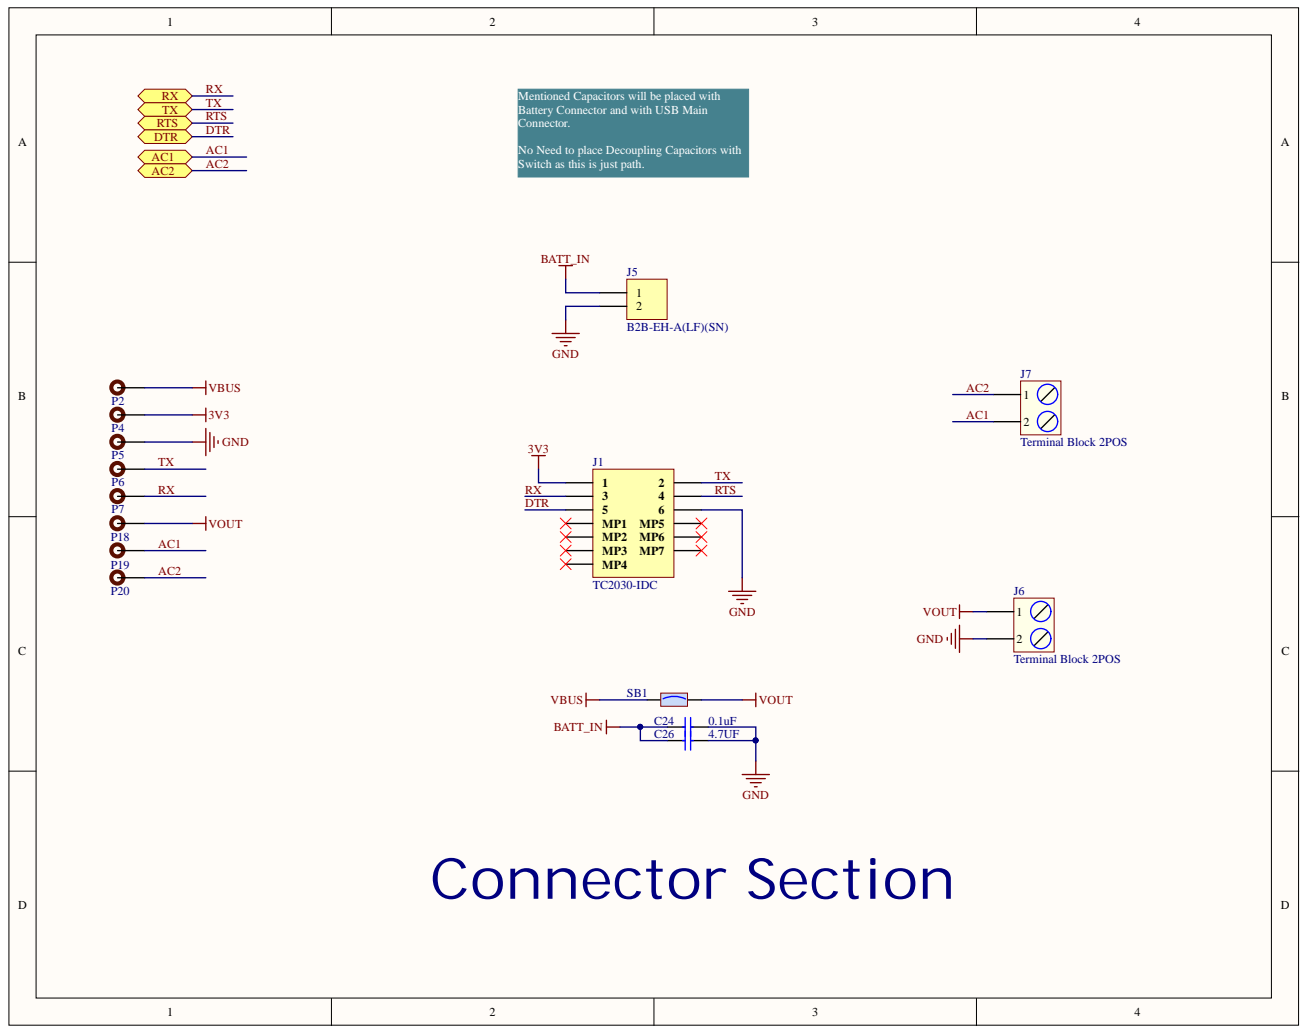
[picture p31: page 7]

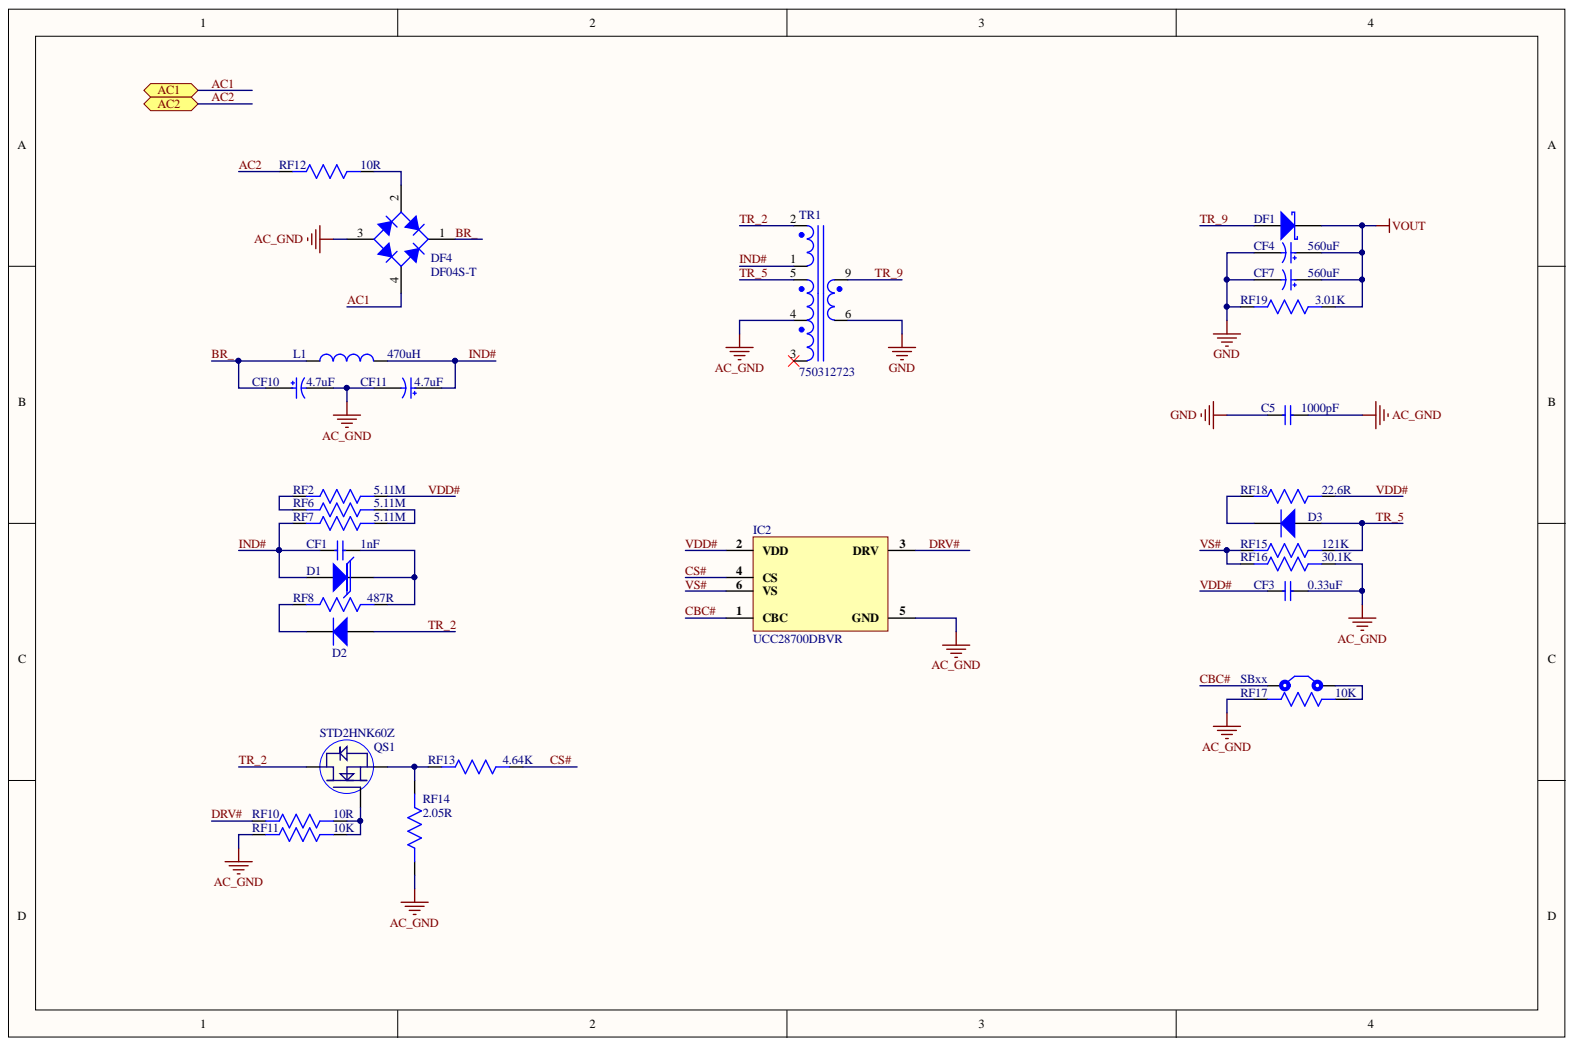
[picture p32: page 8]
