eSpark-Consulting-Group/eduardosuarez-roomonitor/Hardware-Designing/_Design Files v4.5/Assembly Drawings.pdf

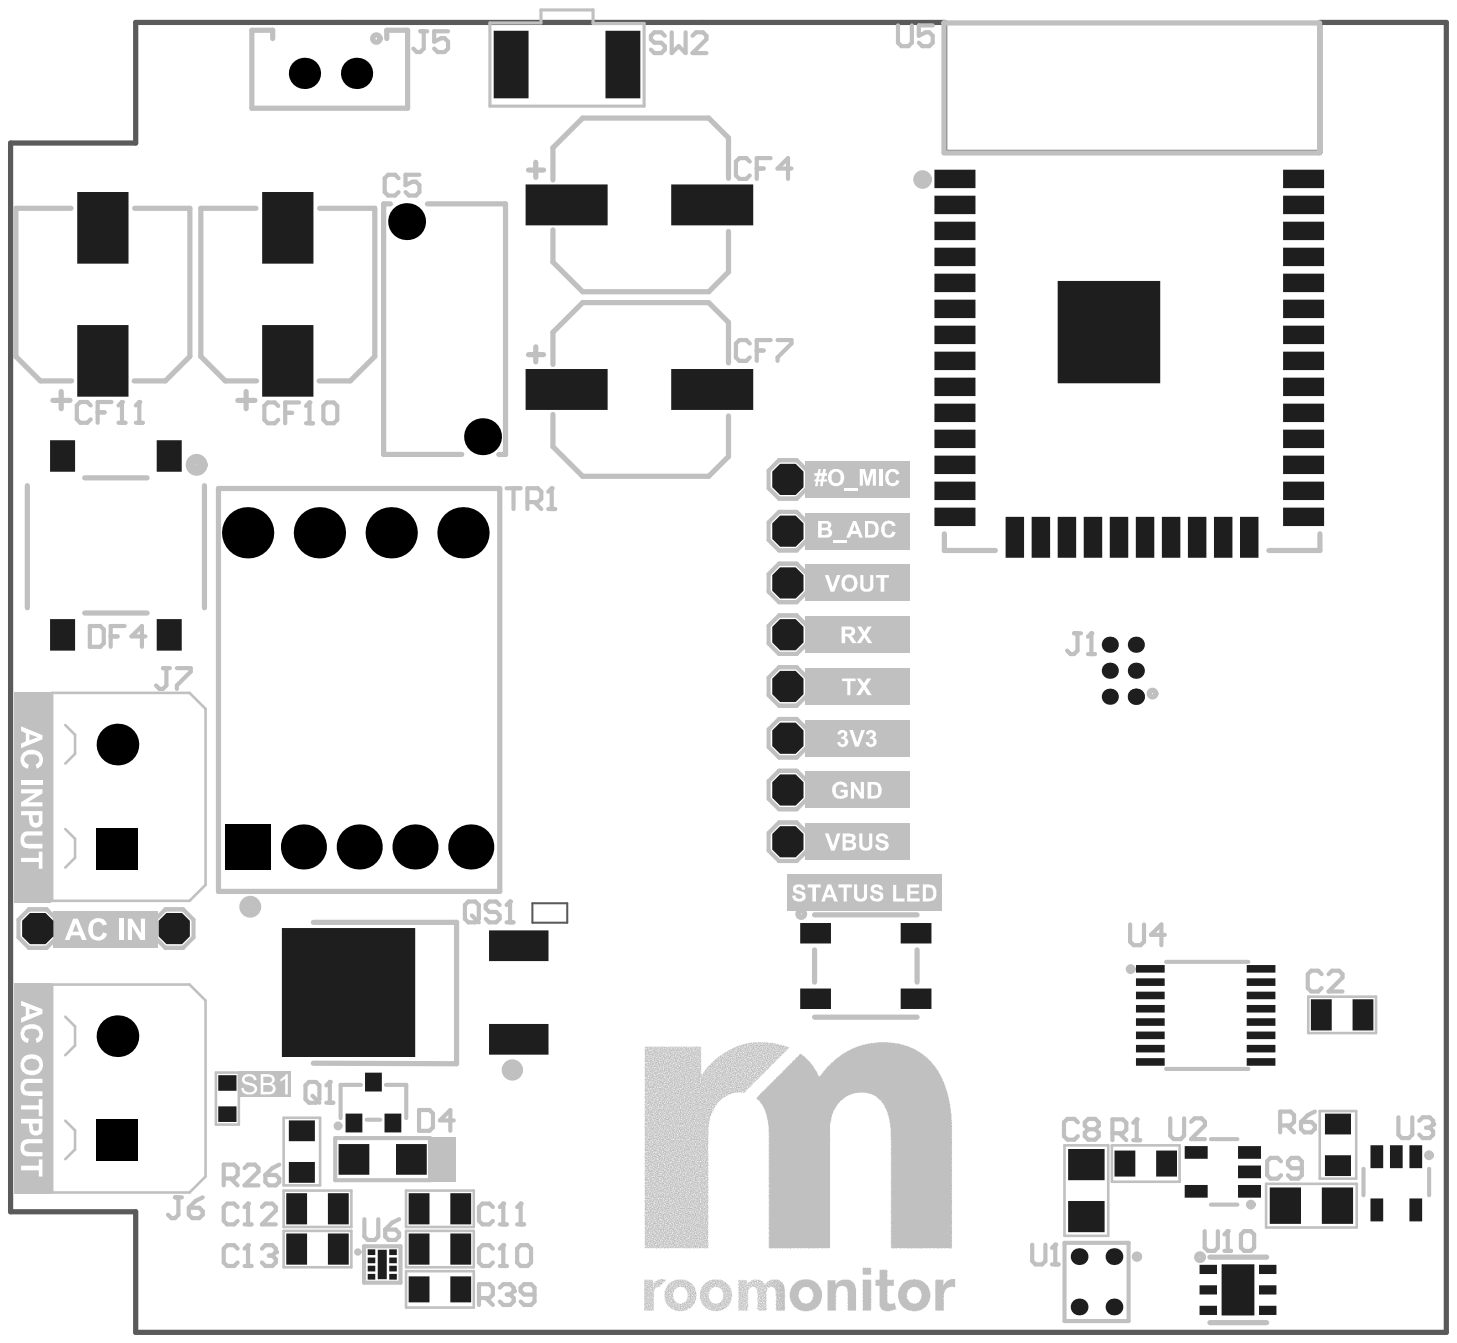
[picture p33: page 1]

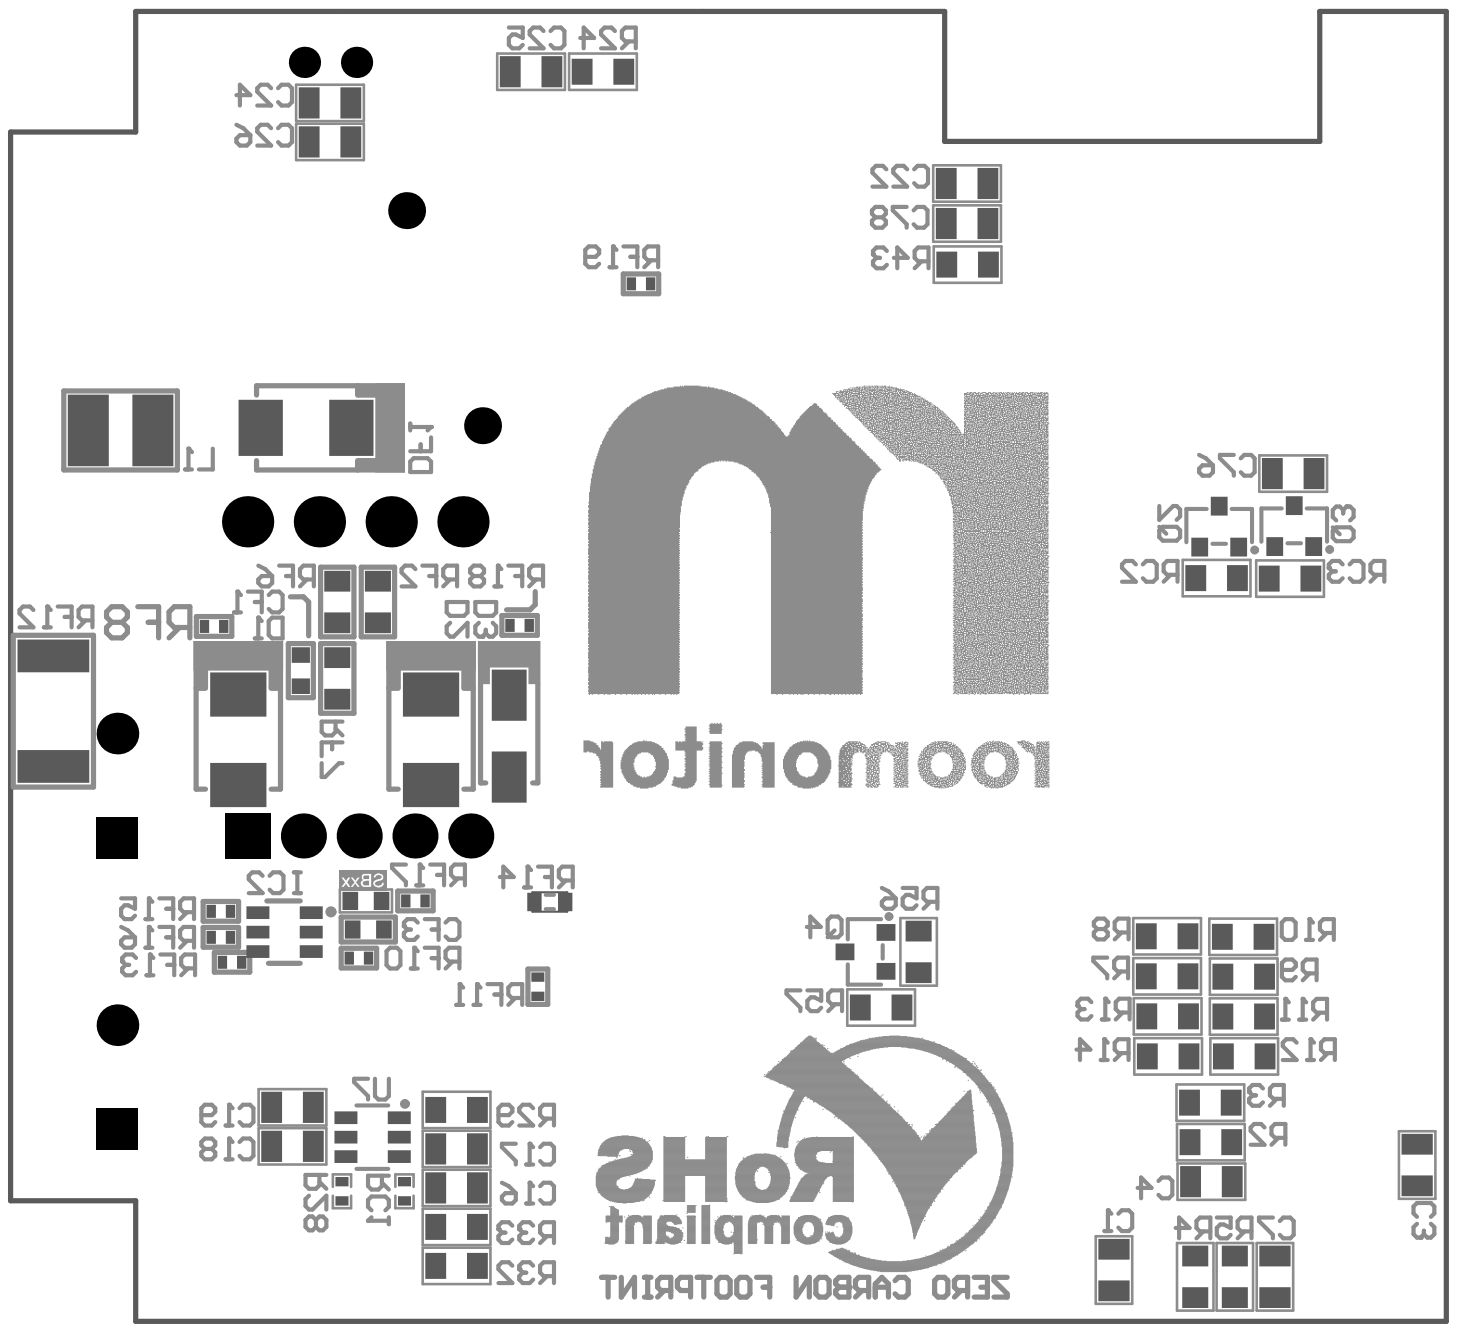
[picture p34: page 2]
