eSpark-Consulting-Group/eduardosuarez-roomonitor/(list of files, drawings)

Other design files:
Hardware-Designing/_Design Files v4.5/Audio_Meter_V4.5.PcbDoc
Hardware-Designing/_Design Files v4.5/Audio_Meter_V4.5.PrjPcb
Hardware-Designing/_Design Files v4.5/Audio_Section.SchDoc
Hardware-Designing/_Design Files v4.5/Battery Charging_Section.SchDoc
Hardware-Designing/_Design Files v4.5/Connector_Section.SchDoc
Hardware-Designing/_Design Files v4.5/Controller_Section.SchDoc
Hardware-Designing/_Design Files v4.5/latest_Audio_Meter_V4.5.PcbDoc
Hardware-Designing/_Design Files v4.5/Power_Section.SchDoc
Hardware-Designing/_Design Files v4.5/Sensor_Section.SchDoc
Hardware-Designing/_Design Files v4.5/SMPS_Section.SchDoc
Hardware-Designing/_Design Files v4.5/Supply_Section.SchDoc
Hardware-Designing/_Design Files v4.5/Top_Sheet.SchDoc
Library-Files/Eduard.PcbLib
Library-Files/Eduard.SchLib
Library-Files/PcbLib.PcbLib
Library-Files/Schlib.SchLib
