eSpark-Consulting-Group/eduardosuarez-roomonitor/(commit log)

2021-03-06 Added latest Design Files and Library Files
    [Audio_Meter_V4.5.DXF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]
2021-03-06 Test Changes.
    [Audio_Meter_V4.5.PcbDoc, Audio_Meter_V4.5.PrjPcb, Audio_Section.SchDoc, Battery Charging_Section.SchDoc, Connector_Section.SchDoc, Controller_Section.SchDoc, Power_Section.SchDoc, Power_Section_SMPS.SchDoc]
2021-03-09 footprints of header
    [1744037-2.stp, 61300211121_Download_STP_61300211121_rev1.stp, Eduard.PcbLib, Eduard.SchLib, TSW-202-07-T-S.stp, User Library-WX DC.step]
2021-03-11 Pin number changes
    [Eduard.PcbLib, Eduard.SchLib]
2021-03-15 Adding latest audio meter PCB
    [Audio_Meter_V4.5.PcbDoc, Audio_Section.SchDoc, Battery Charging_Section.SchDoc, Connector_Section.SchDoc, Controller_Section.SchDoc, Power_Section.SchDoc, SMPS_Section.SchDoc, Sensor_Section.SchDoc]
2021-03-15 step files
    [1744037-2.stp, 61300211121_Download_STP_61300211121_rev1.stp, TSW-202-07-T-S.stp, User Library-WX DC.step]
2021-03-15 Revert "step files"
    This reverts commit 868054d34737885d71525ecd64a84fa729faed76.
    [1744037-2.stp, 61300211121_Download_STP_61300211121_rev1.stp, TSW-202-07-T-S.stp, User Library-WX DC.step]
