eSpark-Consulting-Group/eduardosuarez-roomonitor/(notices)

Notices in the files:
Hardware-Designing/Step files/TSW-202-07-T-S.stp:
FILE_NAME( 'e:/temp/worker_69/temp/exporttempdir_1312_1093_rY9NJ/format_0/TSW-202-07-T-S.stp', '2021-03-09T12:51:00', ( 'License CC BY-ND 4.0' ), ( 'CADENAS' ), ' ', 'PARTsolutions', ' ' );
